laurapellizari/PBLE01---Hardware/README.md

# PBLE01---Hardware
Embedded hardware design for learning

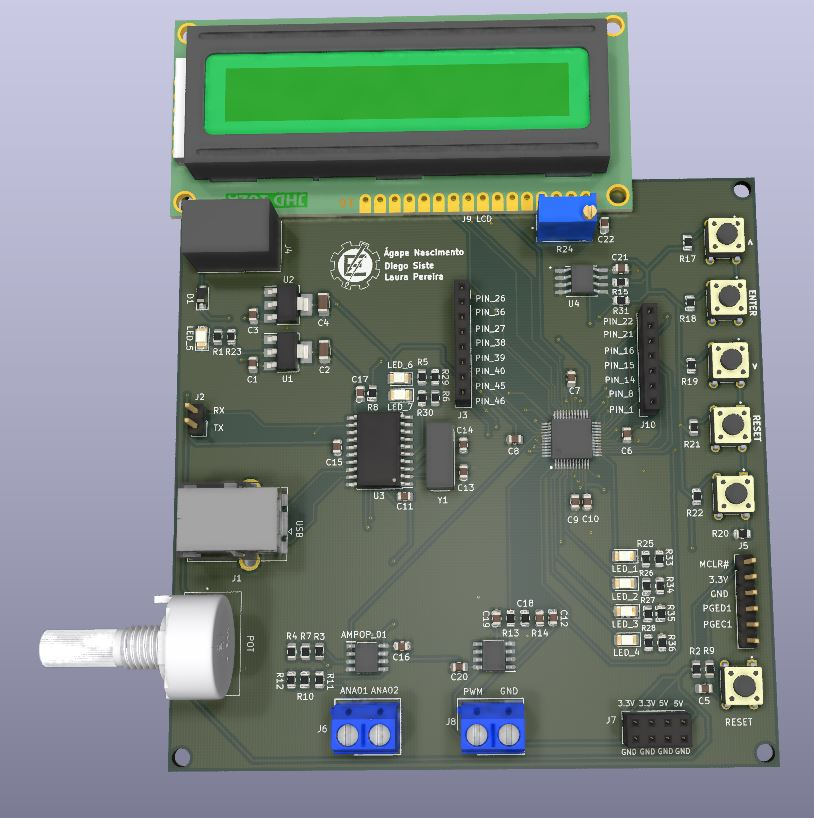
[picture p1: VH3/3D/LCD_visao1.JPG]
