laurapellizari/PBLE01---Hardware/VH3/VH3_RELATORIO.pdf

UNIVERSIDADE FEDERAL DE ITAJUBÁ

APRENDIZAGEM BASEADA EM PROJETOS I

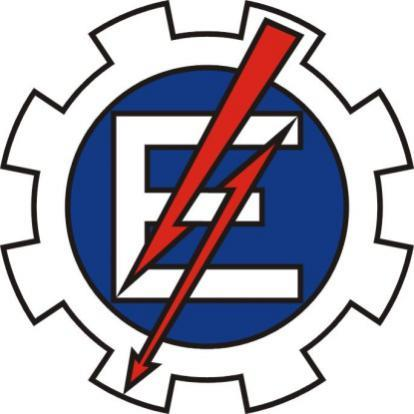
[picture p3: figure]

## Documentação Final

Ágape Guilherme Nascimento da Fonseca – 2018012168

Diego Siste Barbosa – 2019000279

Laura Pellizari Pereira – 2019018756

ITAJUBÁ-MG

2020

Introdução

Este documento possui como objetivo a apresentação de forma detalhada e exemplificada

dos procedimentos e escolhas tomados no desenvolvimento da placa de circuito impresso para

a disciplina Aprendizagem Baseada em Projetos I (PBLE01), do curso de Engenharia Eletrônica

da Universidade Federal de Itajubá (Unifei).

Encontram-se presentes neste registro os requisitos de projeto, esquemas elétricos, layouts,

memoriais de cálculo, anotações referentes a falhas e sucessos, diagramas UML e da máquina

de estado.

Os datasheets citados neste documento encontram-se anexados em uma pasta denominada

“DATASHEETS”.

Sumário

### 1 Hardware

### 1.1. Blocos Funcionais Exigidos

Figura 1 – Blocos Funcionais Exigidos

### 1.2. Subcircuito do Microcontrolador

Especificações:

- Empregar o microcontrolador PIC32MM0064GPM048-I/PT;
- Operar com clock interno;
- Possuir quatro diodos emissores de luz para sinalizações diversas;
- Possuir um botão de reinício do microcontrolador por meio de uma chave táctil de

quatro terminais e do tipo normalmente aberta;

- Possuir uma barra de pinos de programação para o padrão ICSP de 6 pinos (para

gravar o microcontrolador).

Os diodos emissores de luz foram conectados nas entradas digitais 2, 3, 5 e 13 do

microcontrolador.

Utilizando a datasheet “MICRO”, página 24, obteve-se o seguinte circuito para o botão de

reinício e uma barra de pinos no padrão ICSP. Optou-se por PGEC1 e PGED1.

µC

1

### aimentação

2

### comunicação

3

### periféricos

4

### interface

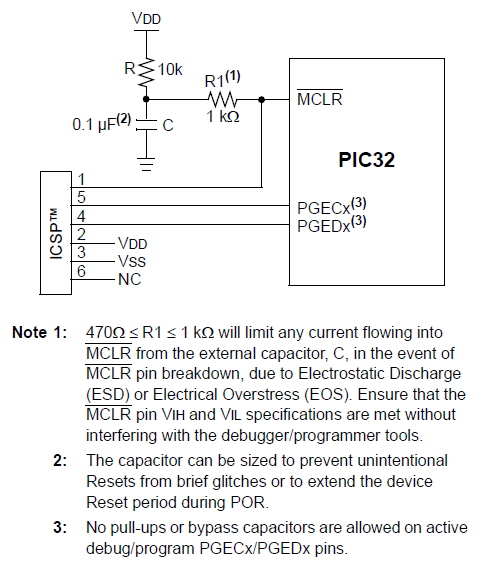
[picture p4: figure]

Figura 2 – Circuito referente ao MCLR

Para o cálculo da resistência do led, foi obtido no datasheet “LTST-C15GKT”, página 4, que

a tensão típica e a corrente típica são, respectivamente, 2.1 V e 20mA.

Dessa maneira,

R =

5− 2.1
0,02

= 145 Ω

Adotando valor comercial, foi utilizado uma associação em série de 100Ω e 56 Ω para as

resistências referentes aos leds.

Esquemático Elaborado:

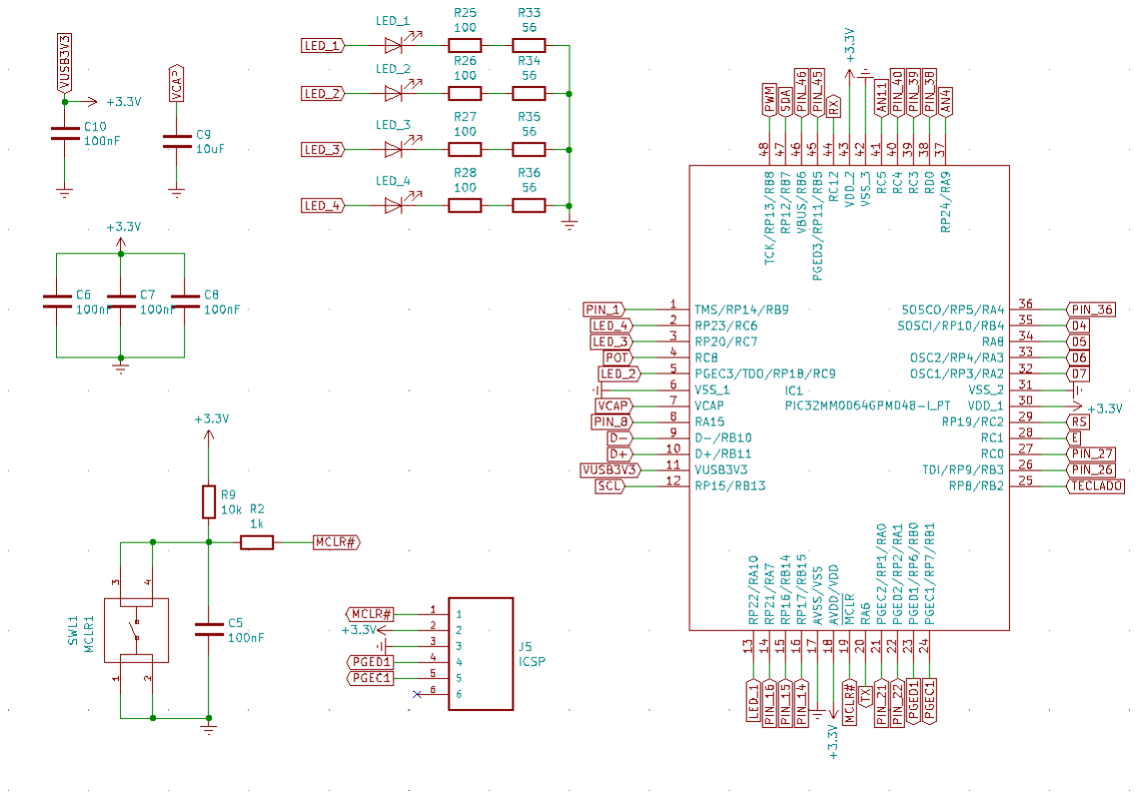
[picture p5: figure]

### 1.3. Subcircuito de Alimentação

Especificações:

- Empregar um conector do tipo jack J4 com diâmetro interno de 2.1mm e pino

central positivo;

•Suportar tensão de entrada na faixa de 7 a 12V em corrente contínua;

•Empregar proteção contra tensão reversa por meio de um diodo retificador

schottky;

•Empregar um regulador linear com saída de 5V;

•Empregar um regulador linear com saída de 3.3V;

•Possuir um diodo emissor de luz para sinalizar a presença de alimentação.

Figura 3 – Esquema Elaborado

Para a implementação do regulador de tensão, baseou – se no circuito encontrado na página

8 do datasheet “LD117” correspondente à imagem abaixo.

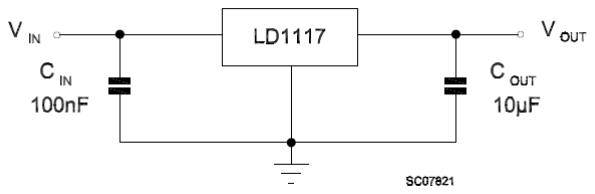
[picture p6: figure]

Para o cálculo da resistência do led foi utilizado o mesmo raciocínio dos leds do

microcontrolador.

Esquemático Elaborado:

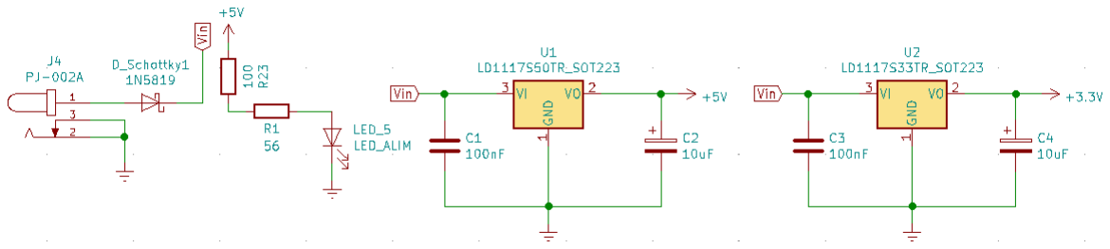
[picture p7: figure]

Figura 5 - Subcircuito de Alimentação

### 1.4. Subcircuito de Comunicação

Especificação:

•Empregar um conversor USB-serial da devidamente integrado ao periférico de

comunicação UART do microcontrolador. Utilizar a configuração autoalimentada para

energizar o conversor;

•Preparar a placa para montar o MCP2200-I/SO

•Fornecer os pinos de TX e RX na borda da placa.

Alimentação:

Como informado no datasheet “MICRO”, página 182, o pino 11 do microcontrolador

(VUSB3V3) é usado para alimentar o transceptor USB, e os pinos 9 e 10 correspondem a,

respectivamente, D- e D+.

Figura 4 - Circuito base para os reguladores de tensão

No mesmo datasheet, na página 318, é informado que a tensão de VUSB3V3 varia de 3.0

V a 3.6 V. Para o projeto foi escolhida uma tensão de 3.3 V.

Já no datasheet “MCP2200”, página 6, é dito que o transceptor USB obtém energia do pino

VUSB, e ainda, na página 1, que a tensão de operação está na faixa de 3.0 a 5.5V. Dessa

maneira, VUSB (pino 17) foi ligado a uma tensão de 3.3V e VDD (pino 1) a uma tensão de 5V.

Seguindo recomendações feitas neste mesmo datasheet, foram utilizados capacitores de

desacoplamento.

Aplicações:

Ainda baseado no mesmo datasheet, página 7, foi obtido o seguinte circuito referente ao

cristal, o qual foi conectado aos pinos 2 e 3.

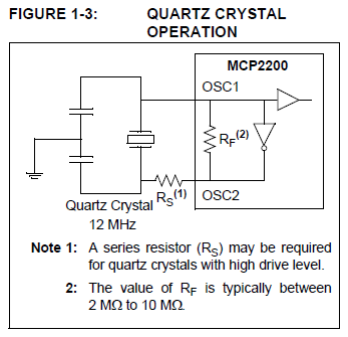
[picture p8: figure]

Figura 6 - Circuito do cristal

Os pinos 5 e 6 foram utilizados como leds de sinalização, cujas resistências foram calculadas

seguindo o mesmo padrão do subcircuito de alimentação e do microcontrolador.

Os pinos 12 e 10 (RX e TX, respectivamente) foram usados para comunicação UART,

conectados aos pinos 20 e 44 do microcontrolador.

O pino 4 foi conectado de maneira a se manter um nível alto constante.

Os demais pinos não foram utilizados.

Esquemático Elaborado:

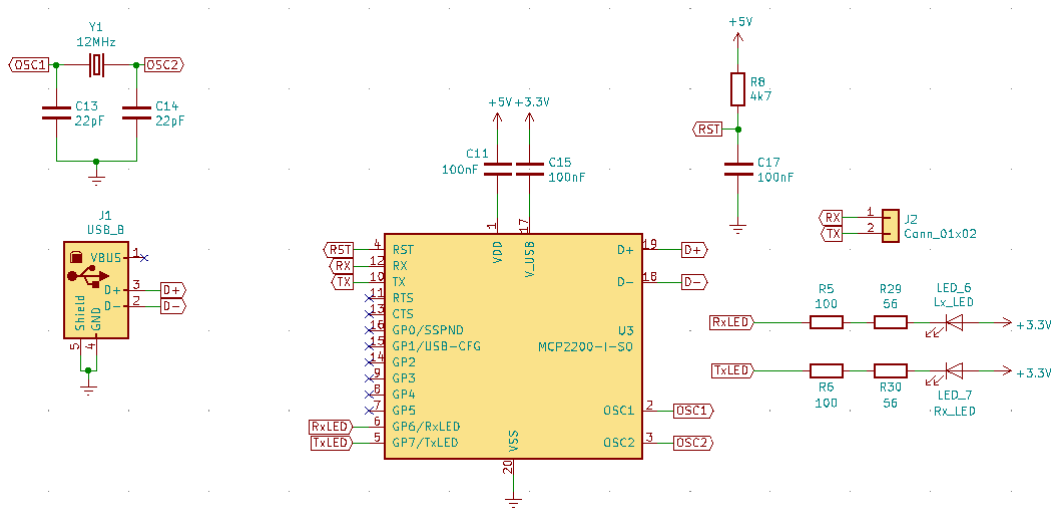
[picture p9: figure]

Figura 7 - Esquema Realizado

### 1.5. Subcircuito de Periféricos

Especificações:

- Possuir uma barra de conexão para um LCD de 16 x 2 pontos compatível com o

dispositivo JHD162A. Tal barra deve contemplar somente os pinos relacionados à

alimentação e à comunicação com o dispositivo por meio do modo de 4 bits. O pino relativo

à funcionalidade de luz de fundo do visor não deve ser energizado. Obs.: o JHD162A pode

ser alimentado com 5V e controlado com sinais de 3.3V (sinais RS, E, DB0-DB7);

- Possuir um teclado de cinco (5) teclas, desenvolvido por meio de chaves tácteis de

quatro (4) terminais cada, sendo lido através de uma estrutura de divisor resistivo numa

entrada analógica;

- Possuir uma memória serial com comunicação no padrão I2C.

A partir do datasheet “JHD162A_ETC”, página 17, foram obtidas as informações sobre a

compatibilidade para uma conexão LCD.

Para o teclado, os cálculos estão anexados na seção “Memorial de cálculo”.

A memória serial teve seus pinos 1, 2, 3 (correspondentes a A0, A1 e A2) conectados ao

terra.

Os pinos 5 e 6, correspondentes a SDA e SCL, foram conectados a um resistor de pull-up

(comunicação padrão I2C) e ao microcontrolador nos pinos 12 e 47, respectivamente.

O pino 7, WP, foi conectado ao terra, configuração esta que mantém a memória em operação

de gravação.

Segundo o datasheet “EEPROM”, página 1, a faixa de tensão de operação da memória em

questão é de 2.5 V a 5.5 V. Assim, o pino 8 foi conectado a 3.3 V, juntamente com um capacitor

de desacoplamento.

O pino 4, VSS, foi ligado ao terra.

Esquemático Elaborado:

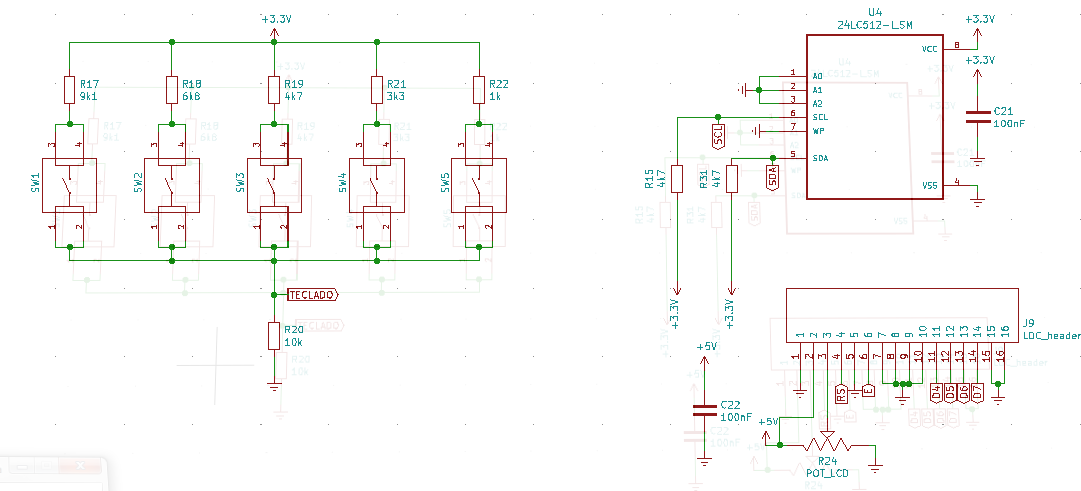
[picture p10: figure]

Figura 8 - Esquema Realizado

### 1.6. Subcircuito de Interface

Especificações:

- Possuir duas entradas analógicas de 0 a 3,3V com circuitos de buffer na entrada;

Possuir um potenciômetro ligado à uma entrada analógica do microcontrolador;

- Possuir uma saída analógica de 0 a 5V conectada a uma saída PWM do micro

utilizando um filtro passa baixa de 2ª ordem (40db/dec.) com 1 década a menos de FC que

a freq. do PWM.;

- Possuir uma barra de conexão para 4 pares de sinais de alimentação, dois como sinal

de 3.3V e dois de 5V, ambos com um terra associado, formato 2x4.

- Possuir um grupo de barras de expansão que empreguem todos os pinos do

microcontrolador que não sejam alocados pelos demais requisitos de desenvolvimento.

Cada barra deverá possuir um conjunto de pinos relativos a um dado periférico do microcontrolador (exemplo: uma barra para o periférico PWM, uma parra para o

periférico SPI, etc.).

Para obter uma faixa de tensão de 0 a 3.3 V foi projetado um divisor resistivo entre 3k3 Ω e

6k6 Ω, de maneira que ao implementar uma tensão de 5V, a tensão de saída será de 3.3V. As

entradas foram conectadas aos pinos 37 e 41 do microcontrolador.

Para os circuitos de buffer foi utilizado apenas um LM358DG, pois este possui dois

amplificadores operacionais.

Ligou-se o potenciômetro ao pino 4 do microcontrolador, correspondente à entrada

analógica.

Reservou-se o pino 48 (MCCP1 OUTPUT A) para o PWM.

Para o cálculo da frequência de corte do PWM, escolheu-se uma resolução de 10 bits
(2¹⁰ = 1024).

Multiplicando pela resolução máxima do microcontrolador , obtida em seu datasheet, na

página 1, temos:
21 ns x 1024 = 2.1504 x 10⁻⁵

Ao multiplicar pelo inverso, temos finalmente a frequência do microcontrolador: (2.1504 x 10⁻⁵
)

-1 = 46.6502 kHz

Como foi pedido uma década a menos, optou-se por utilizar uma frequência de corte de

5kHz.

O tipo de filtro passa baixa escolhido foi o Butterworth, e seus cálculos podem ser

encontrados na seção “Memorial de cálculo”.

Para a barra de conexão foi utilizado um pin header de 02x04 e para a barra de expansão foi

utilizado um de 01x07 e outro de 01x08.

Esquemático Elaborado:

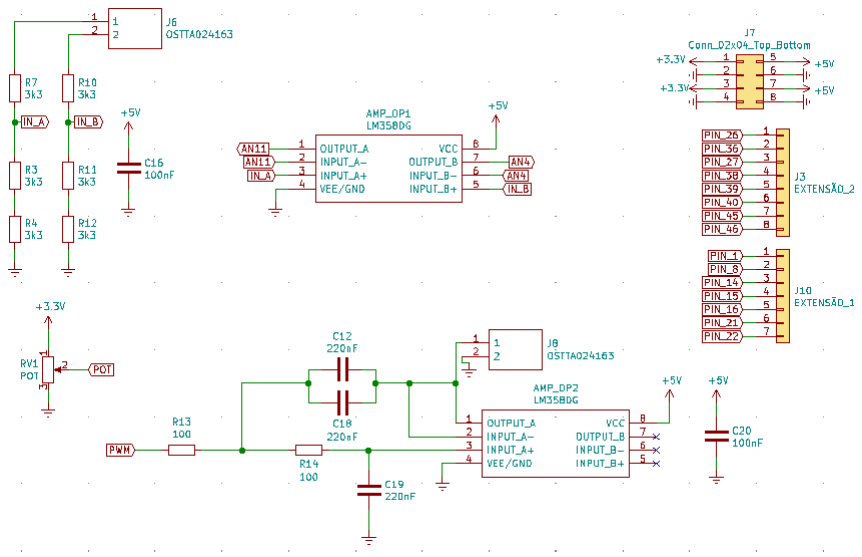
[picture p11: figure]

Figura 9 - Esquema Realizado

### 1.7. Memorial de cálculo e anotações referentes ao projeto:

i) Buffer

Sabendo que a queda de tensão no resistor R2 é de U2 = 3.3V e a queda no resistor R1 é

de U1 = 1.7V, assumimos o valor de 6k6Ω (uma associação em série de 3k3 Ω) para o resistor

R2.

Com o valor da resistência R2 e a tensão aplicada nele, conseguimos obter a corrente total

do circuito em série.

It =

U2
R2

=

3. 3
6600 = 0. 5mA

Com o valor de It e U1, conseguimos achar o valor da resistência R1.

R1 =

U1
It =
1. 7
0. 5 mA

≅ 3. 3kΩ

ii) Teclado analógico

A entrada analógica lê valores de 0 a 1024. Convertendo tensão nessa faixa de valores

temos:

0V – 0

3.3V – 1024

Pressionando SW1, temos:

V =

10k
9k1 + 10k

∗ 3. 3V = 1, 72 V

3.3V = 1024

1,72V = X

X= 533 (valor analógico)

Pressionando SW2, temos:

V =

10k
6k8 + 10k

∗ 3. 3V = 1, 96 V

3.3V = 1024

1,96 V = X

X=608 (valor analógico)

Pressionando SW3, temos:

V =

10k
4k7 + 10k

∗ 3. 3V = 2, 25V

3.3V = 1024

2,25 = X

X=696 (valor analógico)

Pressionando SW4, temos:

V =

10k
3k3 + 10k

∗ 3. 3V = 2, 48V

3.3V = 1024

2,48V = X

X=769 (valor analógico)

Pressionando SW5, temos:

V =

10k
1k + 10k

∗ 3. 3V = 3V

3.3V = 1024

3V = X

X=931 (valor analógico)

iii. Filtro passa-baixa

Para o dimensionamento do filtro, adotou-se como frequência ideal do PWM 5kHZ, e o

filtro Butterworth.

Sabendo que a fórmula da frequência de corte é:

Fc = 1
2√2πRC

Adotando R = 100 Ω, temos que C = 220nF.

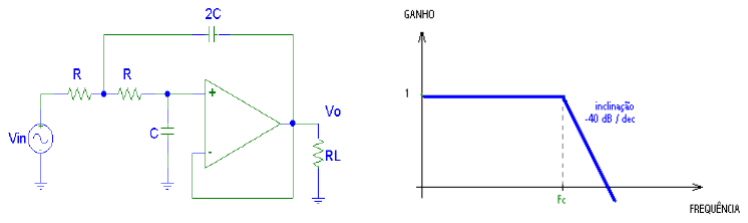
[picture p12: figure]

Figura 10 - Exemplo de filtro encontrado na apostila do prof Carlos Ayres

Para a simulação computacional do filtro foi utilizado o software LTSpice XVII, onde foi construído o seguinte circuito:

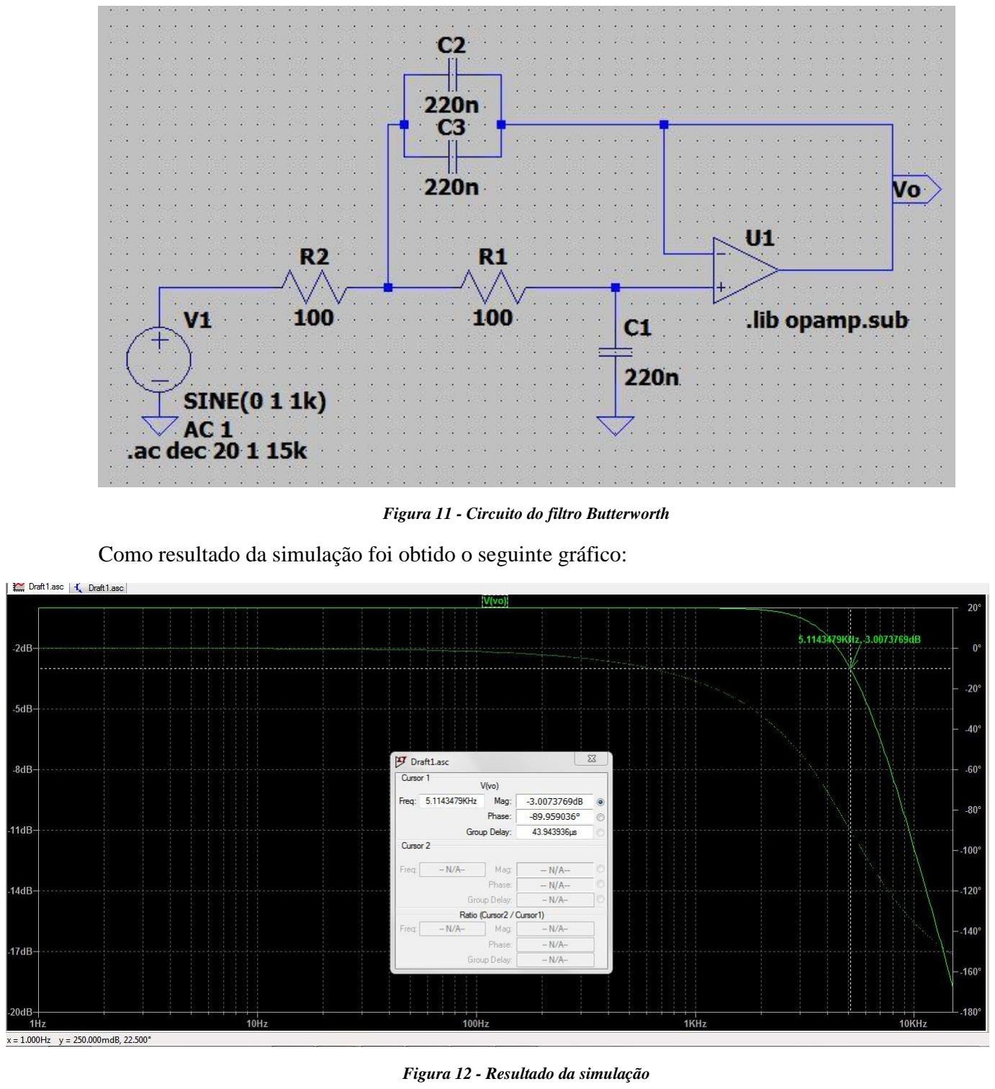
[picture p13: page 15]

Figura 11 - Circuito do filtro Butterworth

Como resultado da simulação foi obtido o seguinte gráfico:

Figura 12 - Resultado da simulação

### 1.8. Desenvolvimento do circuito impresso:

- Possuir dimensão de até 10x10 cm²;
- Ser de dupla face;
- Utilizar plano de terra em ambas as faces;
- Possuir capacitores de supressão de tensão entre a alimentação e o sinal de terra de

cada circuito integrado utilizado pelo projeto, alocados próximos aos pinos de

alimentação;

- Sua face superior deve possuir uma camada de texto (silk) na qual haja a

identificação de cada componente eletroeletrônico;

- Possuir a identificação do grupo e dos integrantes da equipe na camada de texto

(silk);

- Possuir quatro furos de fixação dispostos em seus cantos;
- Possuir identificação de todas as conexões de entrada e de saída presentes na placa.

Dimensão utilizada: 10x10cm.

### 1.9. Desenho virtual da placa e visão 3D:

Desenho virtual:

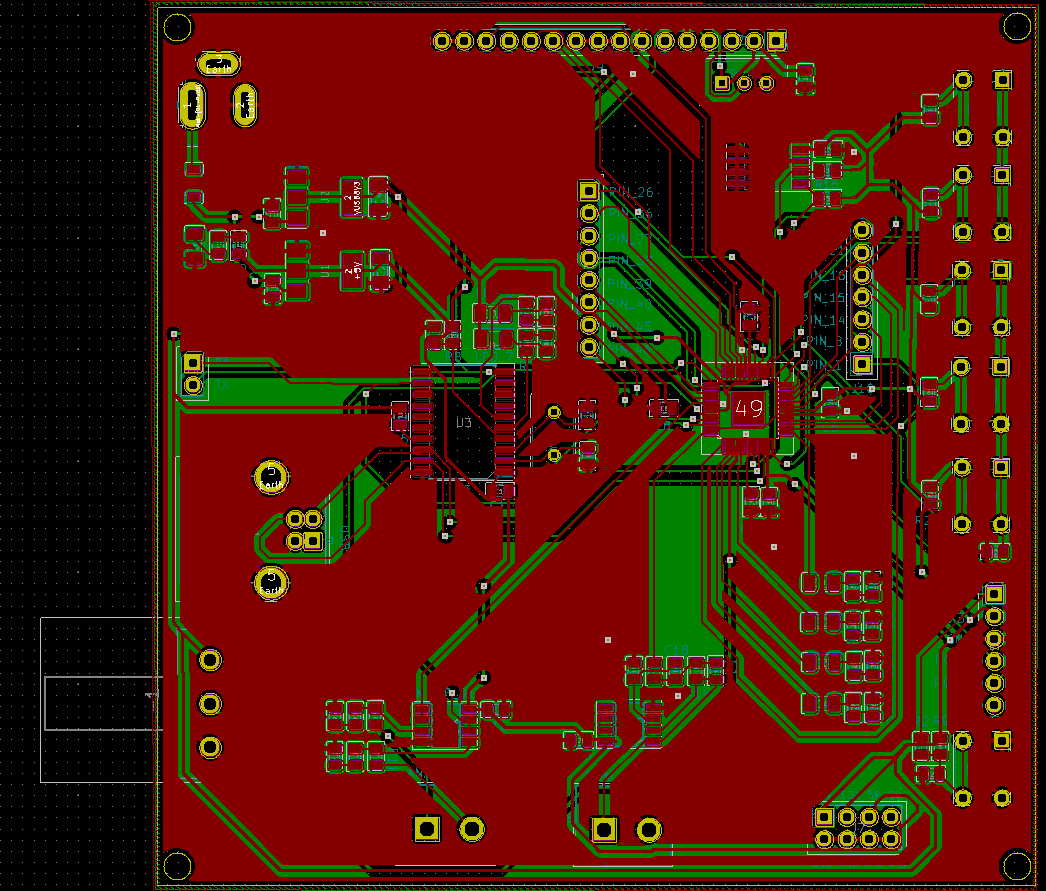
[picture p14: figure]

Figura 13 - Layout

Visão 3D:

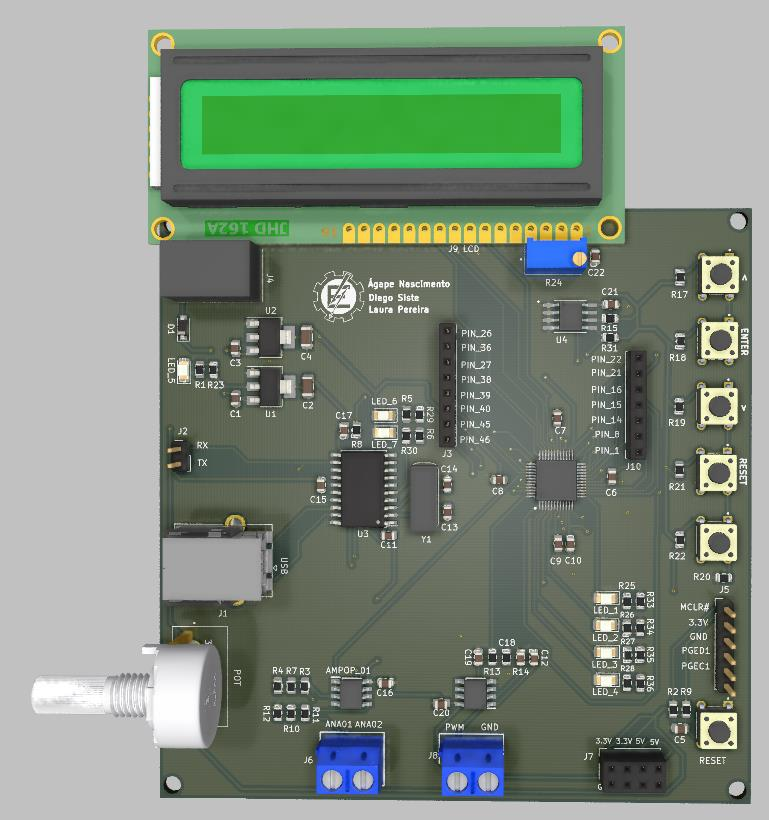
[picture p15: figure]

Figura 15 - Visão 3D

### 2 Software

### 2.1 Máquinas de Estado

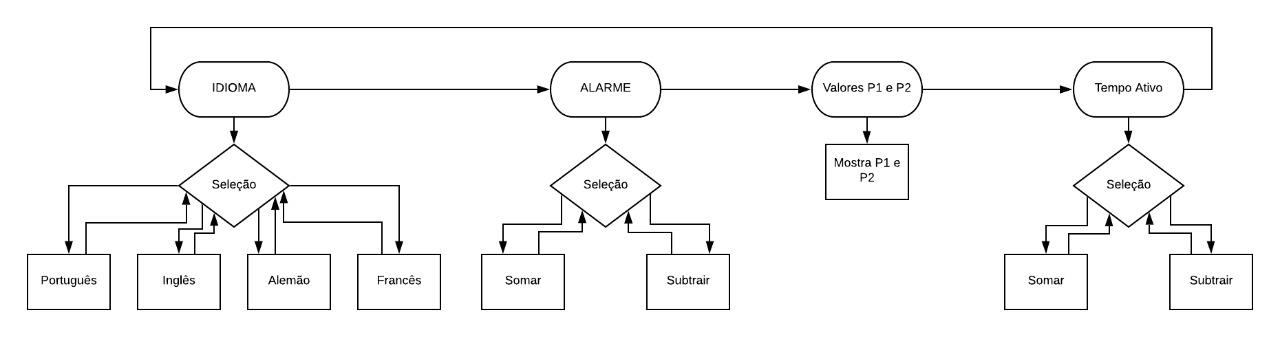
[picture p16: figure]

A máquina de estado em questão foi projetada com o objetivo de operar como um alarme.

Primeiro é feita a escolha de idioma, dentre 4 opções, seguida pela definição do horário do dia

e tempo e do tempo durante o qual ficará em atividade. Após as definições anteriores, são

selecionados os valores a serem sensoriados para o disparo do alarme, encerrando assim as

informações necessárias para funcionamento. Deste modo, a máquina de estado exibirá as horas

até algum disparo de evento iniciá-la novamente.

Figura 15 - Diagrama Máquina de estados

### 2.2 Diagrama UML

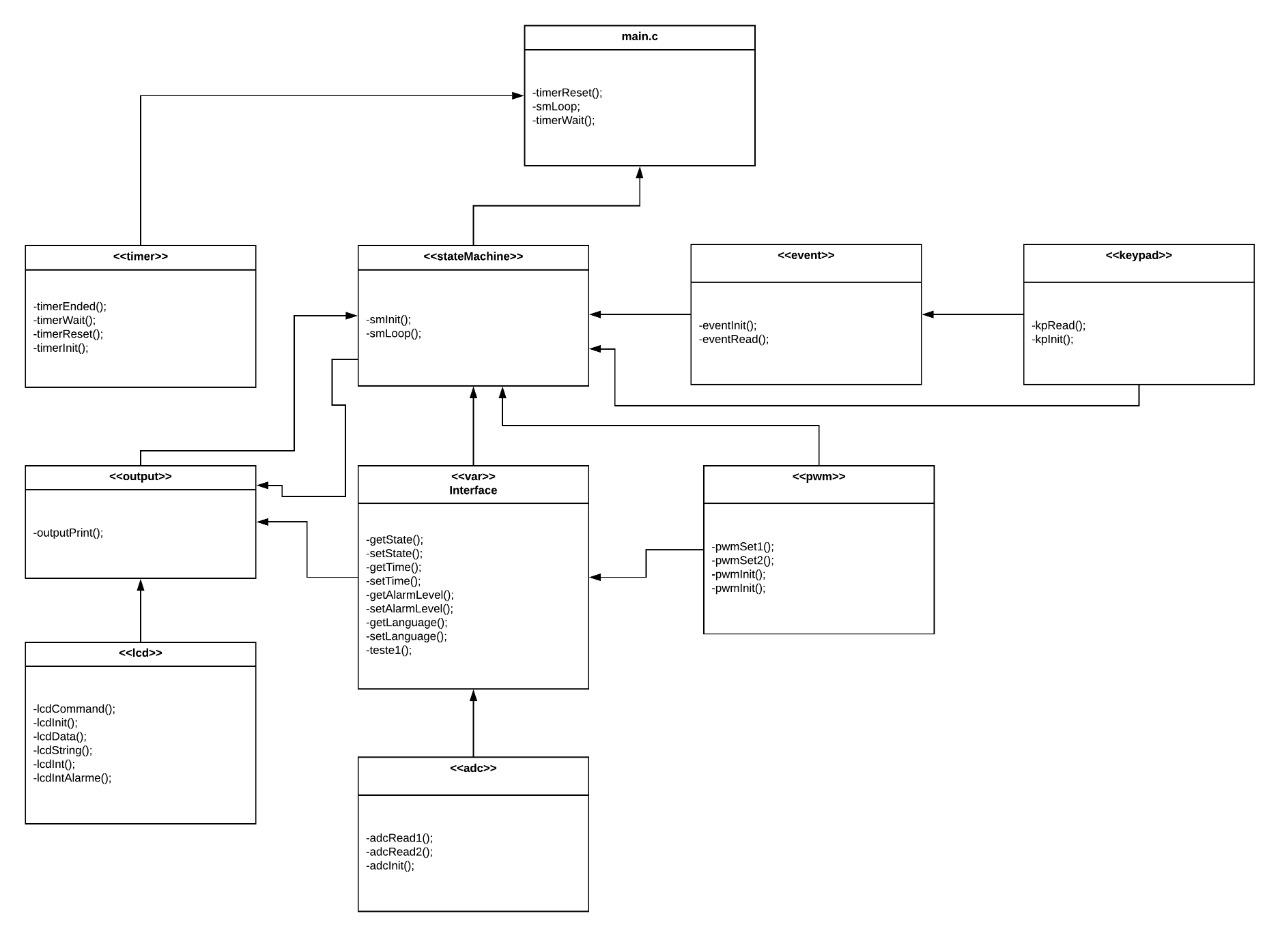
[picture p17: figure]

Figura 16 - Diagrama UML

### 3 Receita de compra de materiais

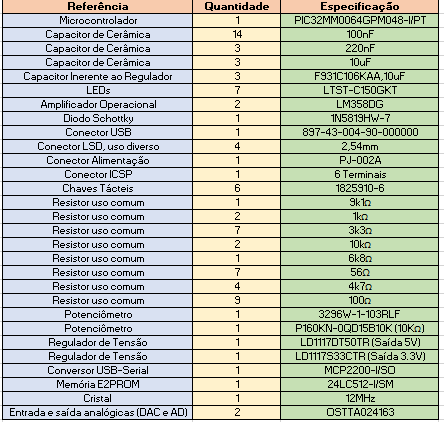
[picture p18: figure]

Figura 17 - Lista de Componentes

### 4 Cotação dos Componentes

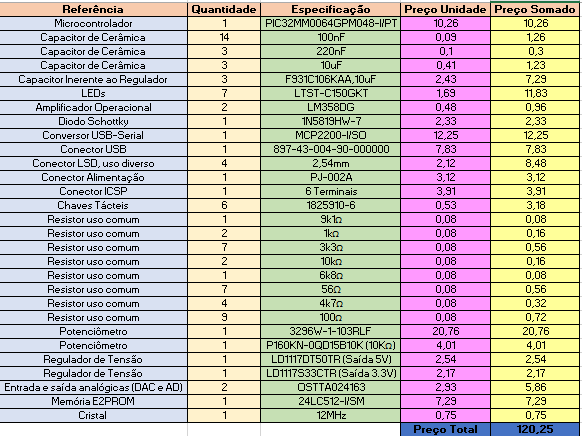
[picture p19: figure]

Figura 18 - Lista de compras

A cotação do projeto incluiu a cotação em dólar de diversos componentes. Assim sendo,

consideramos o valor estipulado de 5,28 Reais no dia da realização.

Tendo em vista o que foi exposto, o custo total do projeto é de R$ 120,25.

### 5 Conclusão

Com o desenvolvimento do trabalho, algumas dificuldades foram encontradas.

Nelas destaca-se o pouco conhecimento do software KiCad somado à falta de prática na

obtenção de informações de folhas de dados; isto levou o grupo a algumas divergências quanto

à representação esquemática do circuito.

Por exemplo, na representação do circuito em formato PCB foi necessária a utilização de

footprints, o que implica adicioná-las ao software. Todavia, diversos componentes não estavam

associados às footprints corretas, portanto foi preciso alterar algumas já existentes para que se

adequassem ao projeto. Situação parecida se deu com a visualização do modelo 3D.

Foi preciso empregar grande quantidade de vias no processo de roteamento da PCB, uma

vez que apenas utilizar as duas faces não foi suficiente para evitar o cruzamento de linhas.

Evidencia-se também a falta de datasheets com qualidade para certos componentes. Uma

vez que apresentam uma quantidade pequena de informações, acabam tornando trabalhoso seu

entendimento e utilização.

Assim sendo, registra-se que a maioria dos problemas acabaram sendo solucionados por

meio de pesquisas na Internet, baseando-se em projetos antigos e com o suporte fornecido pelo

professor da disciplina.

### 6 Anexos

i. Especificações elétricas da placa
- Tensão de Alimentação: 7 a 12V
- Tensão entradas analógicas: 0 a 5V
- Tensão Saída PWM: 0 a 5V
