laurapellizari/PBLE01---Hardware/sub_circ_alim/sub_circ_alim.jpg

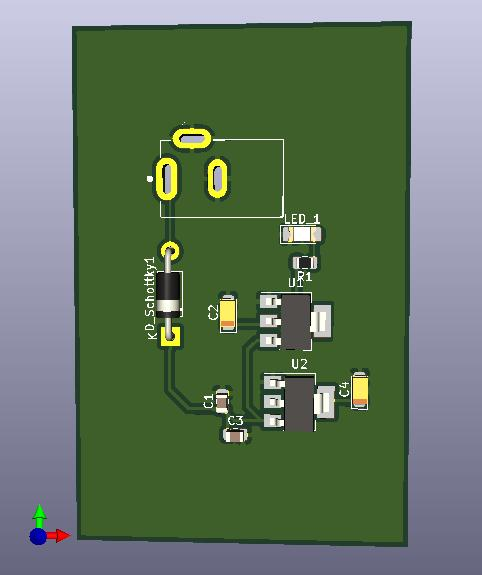
sub_circ_alim/sub_circ_alim.jpg
