laurapellizari/PBLE01---Hardware/sub_circ_completos/pcb_3D.jpg

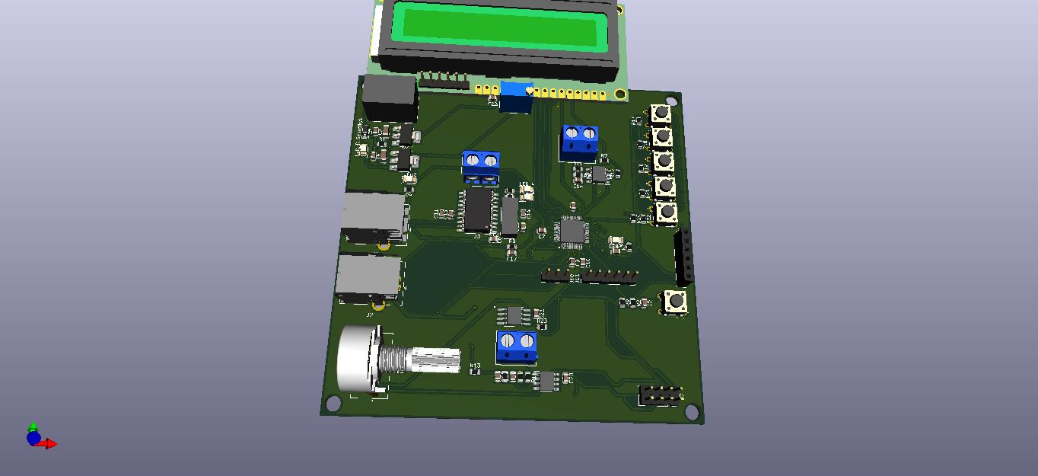
sub_circ_completos/pcb_3D.jpg
