laurapellizari/PBLE01---Hardware/sub_circ_completos/sem-nome2.jpg

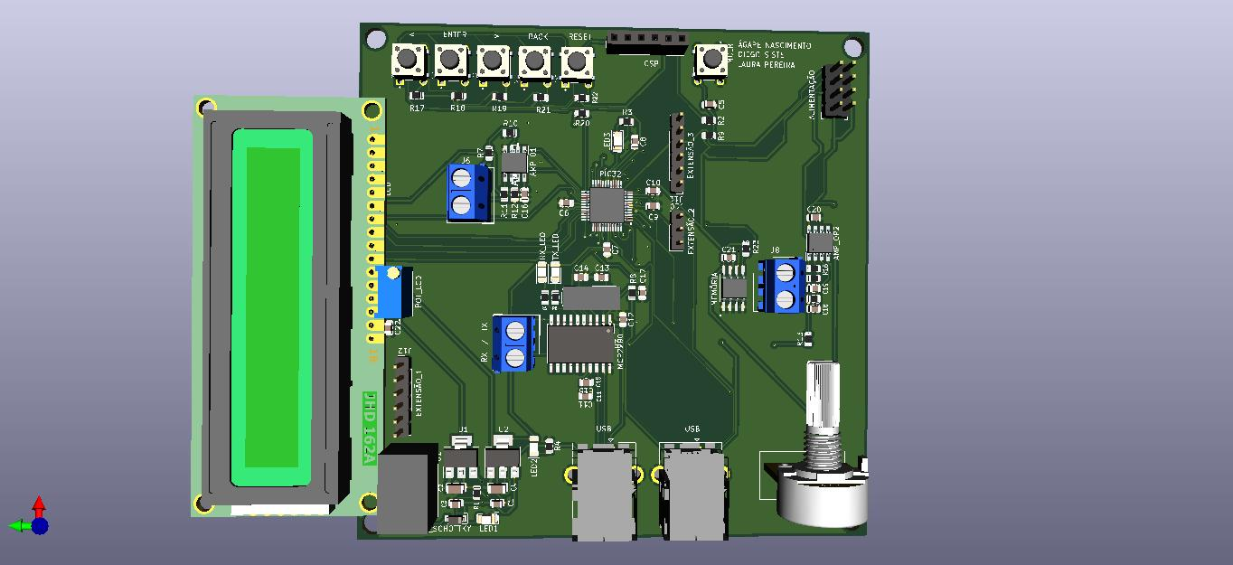
sub_circ_completos/sem-nome2.jpg
