laurapellizari/PBLE01---Hardware/sub_circ_completos/sem-nome.jpg

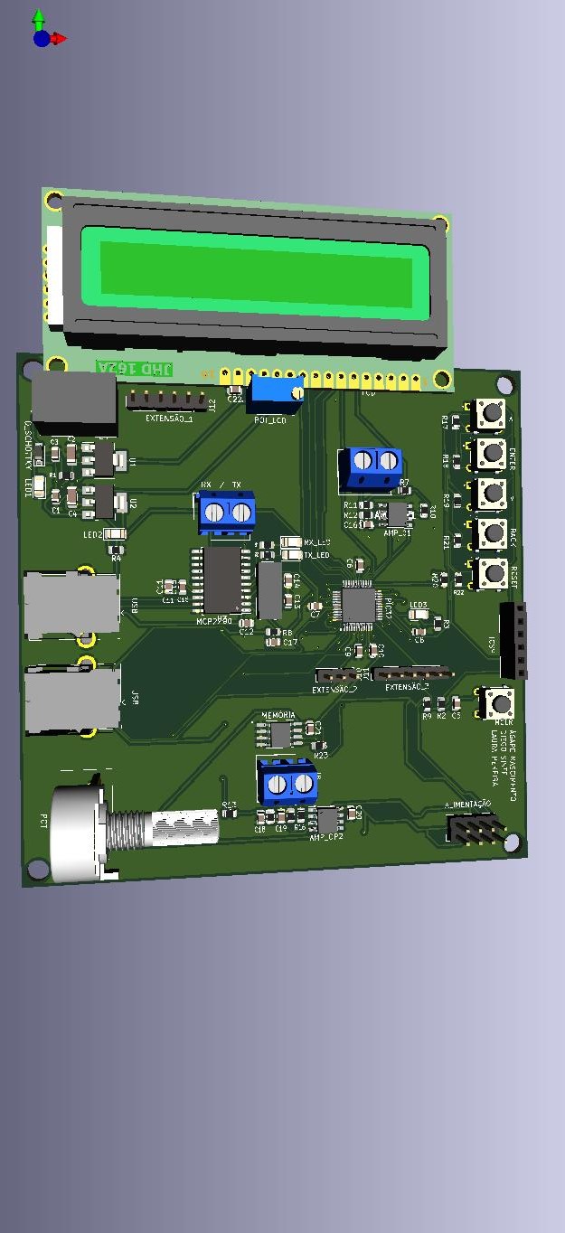
sub_circ_completos/sem-nome.jpg
