laurapellizari/PBLE01---Hardware/sub_circ_comunicacao/sub_circ_comunicacao.png

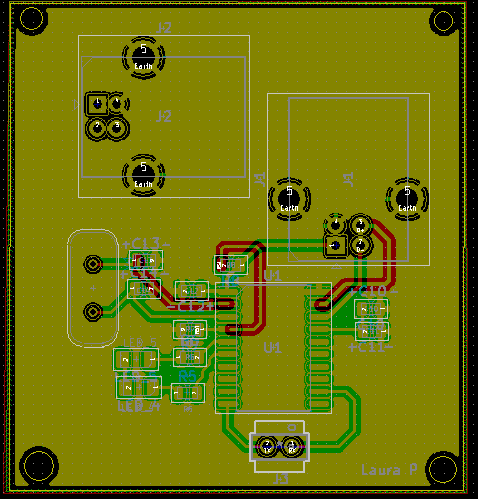
sub_circ_comunicacao/sub_circ_comunicacao.png
