laurapellizari/PBLE01---Hardware/sub_circ_interface/sub_circ_interface.png

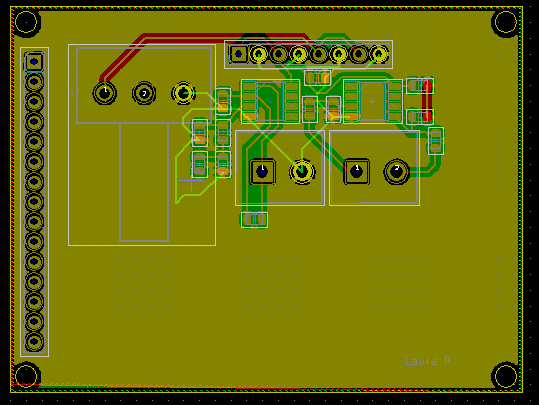
sub_circ_interface/sub_circ_interface.png
