laurapellizari/PBLE01---Hardware/sub_circ_perifericos/sub_circ_perifericos.png

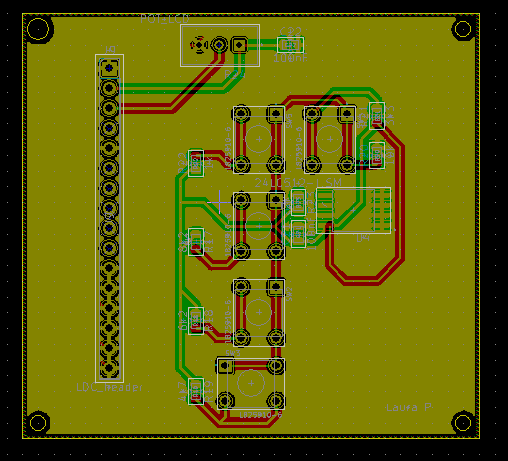
sub_circ_perifericos/sub_circ_perifericos.png
