laurapellizari/PBLE01---Hardware/documentacao/lista_de_compras.xlsx

Referência | Quantidade | Especificação | Preço Unidade | Preço Somado | Referência | Quantidade | Especificação
Microcontrolador | 1 | PIC32MM0064GPM048-I/PT | 10.26 | 10.26 | Microcontrolador | 1 | PIC32MM0064GPM048-I/PT
Capacitor de Cerâmica | 14 | 100nF | 0.09 | 1.26 | Capacitor de Cerâmica | 14 | 100nF
Capacitor de Cerâmica | 3 | 220nF | 0.1 | 0.3 | Capacitor de Cerâmica | 3 | 220nF
Capacitor de Cerâmica | 3 | 10uF | 0.41 | 1.23 | Capacitor de Cerâmica | 3 | 10uF
Capacitor Inerente ao Regulador | 3 | F931C106KAA,10uF | 2.43 | 7.29 | Capacitor Inerente ao Regulador | 3 | F931C106KAA,10uF
LEDs | 7 | LTST-C150GKT | 1.69 | 11.83 | LEDs | 7 | LTST-C150GKT
Amplificador Operacional | 2 | LM358DG | 0.48 | 0.96 | Amplificador Operacional | 2 | LM358DG
Diodo Schottky | 1 | 1N5819HW-7 | 2.33 | 2.33 | Diodo Schottky | 1 | 1N5819HW-7
Conversor USB-Serial | 1 | MCP2200-I/SO | 12.25 | 12.25 | Conector USB | 1 | 897-43-004-90-000000
Conector USB | 1 | 897-43-004-90-000000 | 7.83 | 7.83 | Conector LSD, uso diverso | 4 | 2,54mm
Conector LSD, uso diverso | 4 | 2,54mm | 2.12 | 8.48 | Conector Alimentação | 1 | PJ-002A
Conector Alimentação | 1 | PJ-002A | 3.12 | 3.12 | Conector ICSP | 1 | 6 Terminais
Conector ICSP | 1 | 6 Terminais | 3.91 | 3.91 | Chaves Tácteis | 6 | 1825910-6
Chaves Tácteis | 6 | 1825910-6 | 0.53 | 3.18 | Resistor uso comum | 1 | 9k1Ω
Resistor uso comum | 1 | 9k1Ω | 0.08 | 0.08 | Resistor uso comum | 2 | 1kΩ
Resistor uso comum | 2 | 1kΩ | 0.08 | 0.16 | Resistor uso comum | 7 | 3k3Ω
Resistor uso comum | 7 | 3k3Ω | 0.08 | 0.56 | Resistor uso comum | 2 | 10kΩ
Resistor uso comum | 2 | 10kΩ | 0.08 | 0.16 | Resistor uso comum | 1 | 6k8Ω
Resistor uso comum | 1 | 6k8Ω | 0.08 | 0.08 | Resistor uso comum | 7 | 56Ω
Resistor uso comum | 7 | 56Ω | 0.08 | 0.56 | Resistor uso comum | 4 | 4k7Ω
Resistor uso comum | 4 | 4k7Ω | 0.08 | 0.32 | Resistor uso comum | 9 | 100Ω
Resistor uso comum | 9 | 100Ω | 0.08 | 0.72 | Potenciômetro | 1 | 3296W-1-103RLF
Potenciômetro | 1 | 3296W-1-103RLF | 20.76 | 20.76 | Potenciômetro | 1 | P160KN-0QD15B10K (10KΩ)
Potenciômetro | 1 | P160KN-0QD15B10K (10KΩ) | 4.01 | 4.01 | Regulador de Tensão | 1 | LD1117DT50TR (Saída 5V)
Regulador de Tensão | 1 | LD1117DT50TR (Saída 5V) | 2.54 | 2.54 | Regulador de Tensão | 1 | LD1117S33CTR (Saída 3.3V)
Regulador de Tensão | 1 | LD1117S33CTR (Saída 3.3V) | 2.17 | 2.17 | Conversor USB-Serial | 1 | MCP2200-I/SO
Entrada e saída analógicas (DAC e AD) | 2 | OSTTA024163 | 2.93 | 5.86 | Memória E2PROM | 1 | 24LC512-I/SM
Memória E2PROM | 1 | 24LC512-I/SM | 7.29 | 7.29 | Cristal | 1 | 12MHz
Cristal | 1 | 12MHz | 0.75 | 0.75 | Entrada e saída analógicas (DAC e AD) | 2 | OSTTA024163
 |  |  | Preço Total | 120.25
