laurapellizari/PBLE01---Hardware/documentacao/componentes/3D/c-292304-1-b-3d.igs

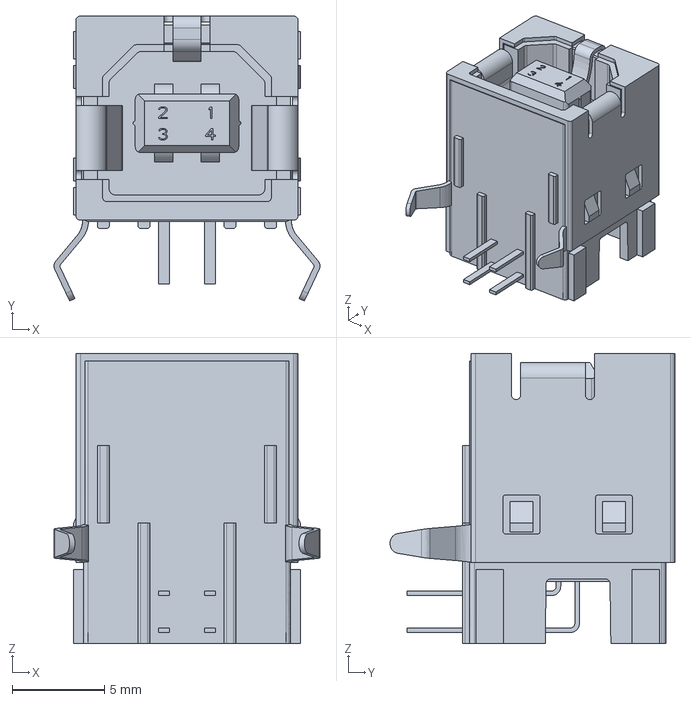
[picture p30: CAD file, 2022-01-19]
documentacao/componentes/3D/c-292304-1-b-3d.igs
14.4 x 15.4 x 15.7 mm
