laurapellizari/PBLE01---Hardware/VH3/COMPONENTES/3D/MCP2200-I_SO.stp

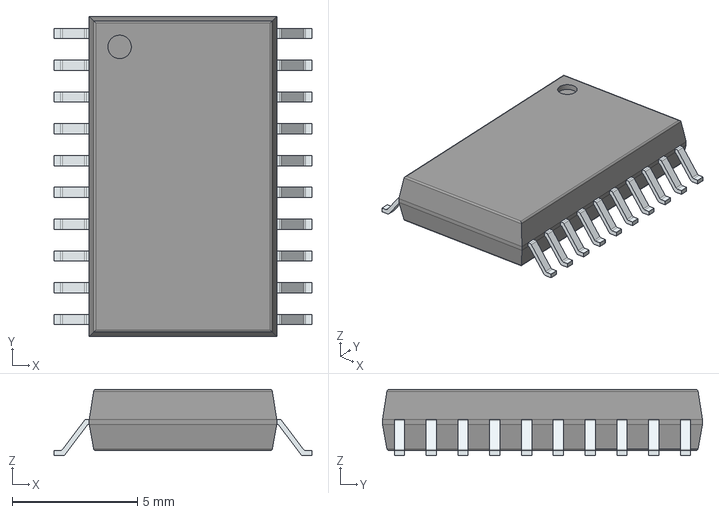
[picture p32: CAD file, 2022-01-19]
VH3/COMPONENTES/3D/MCP2200-I_SO.stp
10.3 x 12.8 x 2.65 mm
PinsArrayLR
