laurapellizari/PBLE01---Hardware/documentacao/componentes/3D/PIC32MM0256GPM048-I_PT.stp

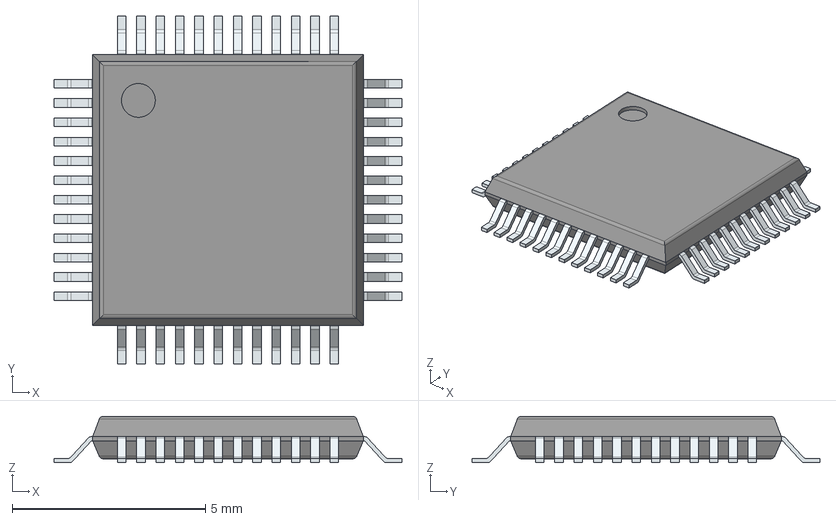
[picture p33: CAD file, 2022-01-19]
documentacao/componentes/3D/PIC32MM0256GPM048-I_PT.stp
9.00 x 9.00 x 1.20 mm
PinsArrayLR
PinsArrayTB
