laurapellizari/PBLE01---Hardware/VH3/COMPONENTES/3D/ATS12A.stp

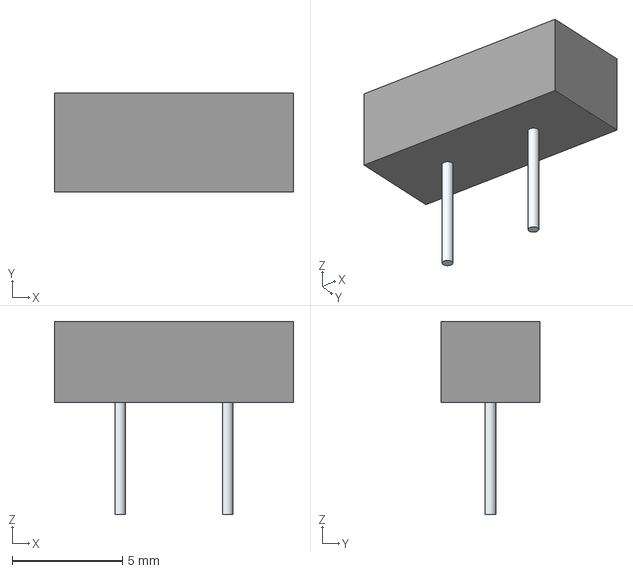
[picture p34: CAD file, 2022-01-19]
VH3/COMPONENTES/3D/ATS12A.stp
10.8 x 4.50 x 8.78 mm
Leads x 2
