laurapellizari/PBLE01---Hardware/VH3/COMPONENTES/3D/47K Potenziometer.step

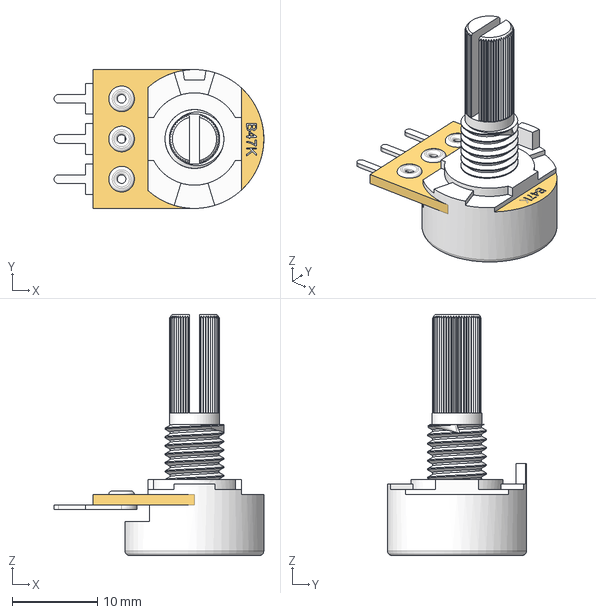
[picture p35: CAD file, 2022-01-19]
VH3/COMPONENTES/3D/47K Potenziometer.step
24.6 x 16.2 x 28.2 mm
