laurapellizari/PBLE01---Hardware/documentacao/componentes/3D/DPAK-L.step

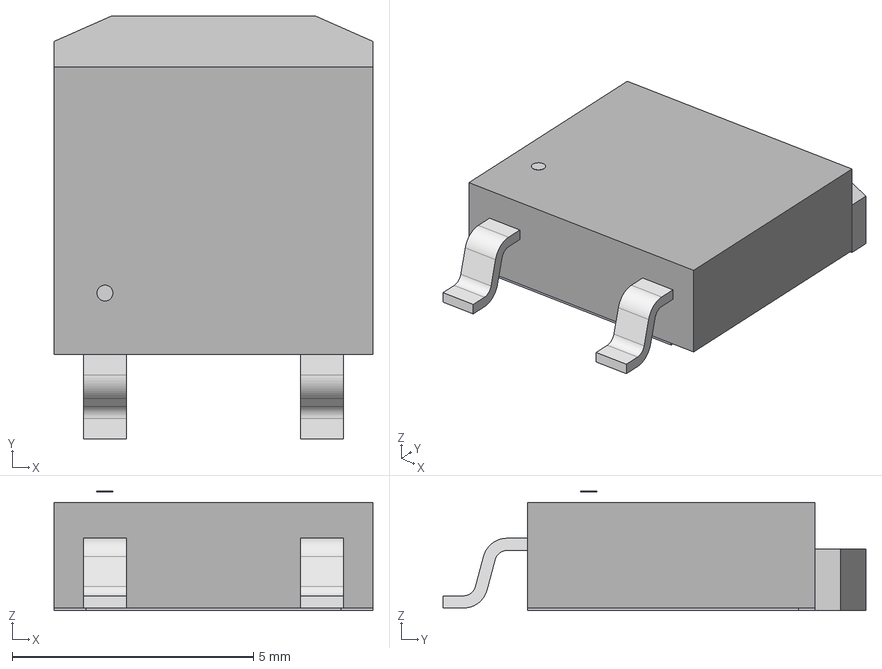
[picture p36: CAD file, 2022-01-19]
documentacao/componentes/3D/DPAK-L.step
6.60 x 8.77 x 2.47 mm
