laurapellizari/PBLE01---Hardware/documentacao/componentes/3D/tb5p-2p_p5_l10_w7-6_h10.stp

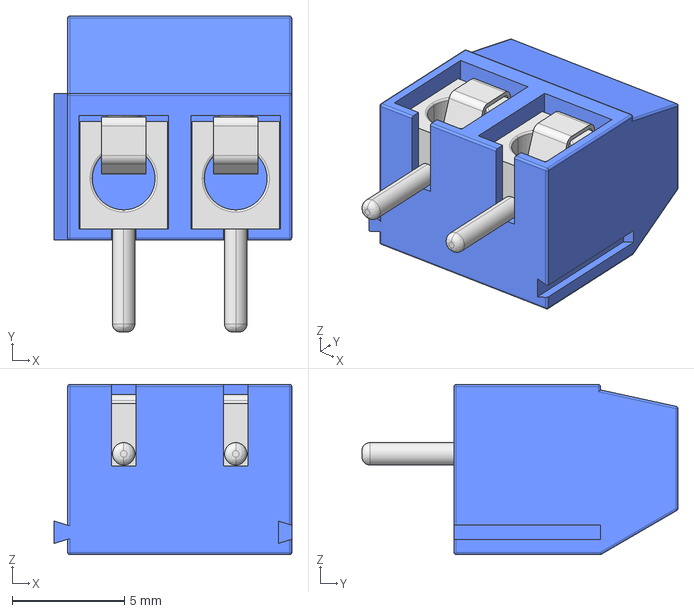
[picture p37: CAD file, 2022-01-19]
documentacao/componentes/3D/tb5p-2p_p5_l10_w7-6_h10.stp
10.6 x 14.1 x 7.60 mm
