laurapellizari/PBLE01---Hardware/documentacao/componentes/3D/LM358DG.stp

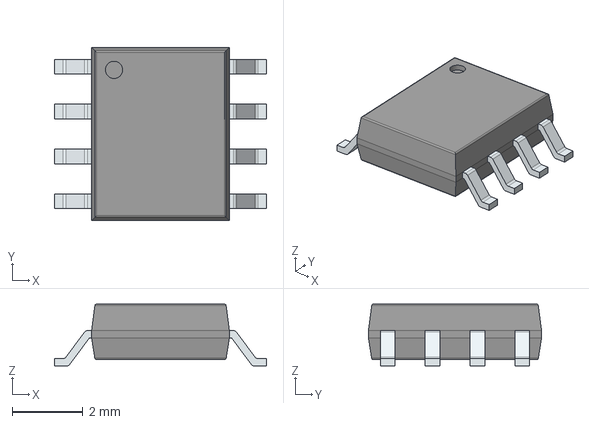
[picture p39: CAD file, 2022-01-19]
documentacao/componentes/3D/LM358DG.stp
6.00 x 4.90 x 1.75 mm
PinsArrayLR
