laurapellizari/PBLE01---Hardware/documentacao/componentes/3D/User Library-LCD 16x2 JHD162A.STEP

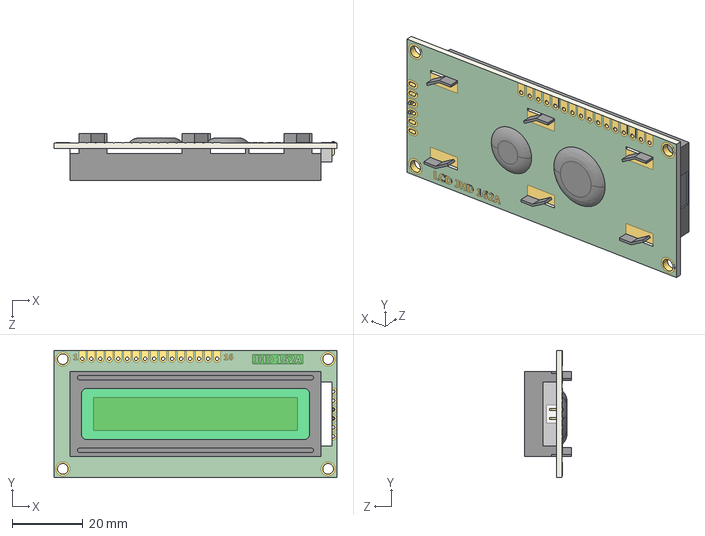
[picture p40: CAD file, 2022-01-19]
documentacao/componentes/3D/User Library-LCD 16x2 JHD162A.STEP
80.0 x 36.0 x 13.2 mm
