laurapellizari/PBLE01---Hardware/documentacao/componentes/3D/PJ-002AH.stp

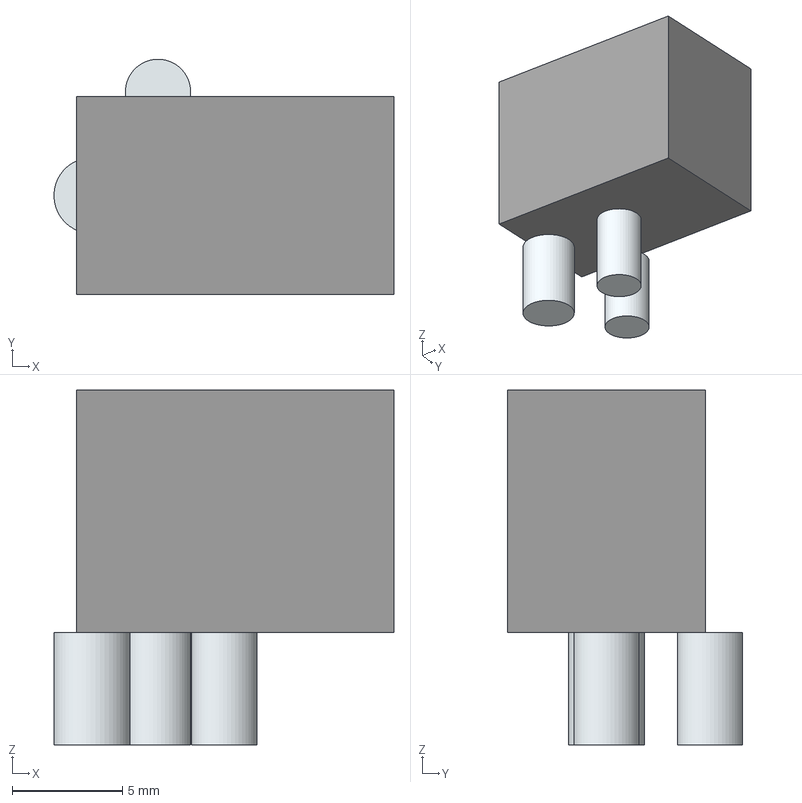
[picture p41: CAD file, 2022-01-19]
documentacao/componentes/3D/PJ-002AH.stp
15.4 x 10.7 x 16.1 mm
Leads x 3
