laurapellizari/PBLE01---Hardware/(list of files, cad)

Other CAD files:
VH3/COMPONENTES/3D/1825910-6--3DModel-STEP-56544.STEP
VH3/COMPONENTES/3D/PJ-002AH.stl
documentacao/componentes/3D/1825910-6--3DModel-STEP-56544.STEP
documentacao/componentes/3D/PJ-002AH.stl
