laurapellizari/PBLE01---Hardware/VH3/MANUAL.pdf

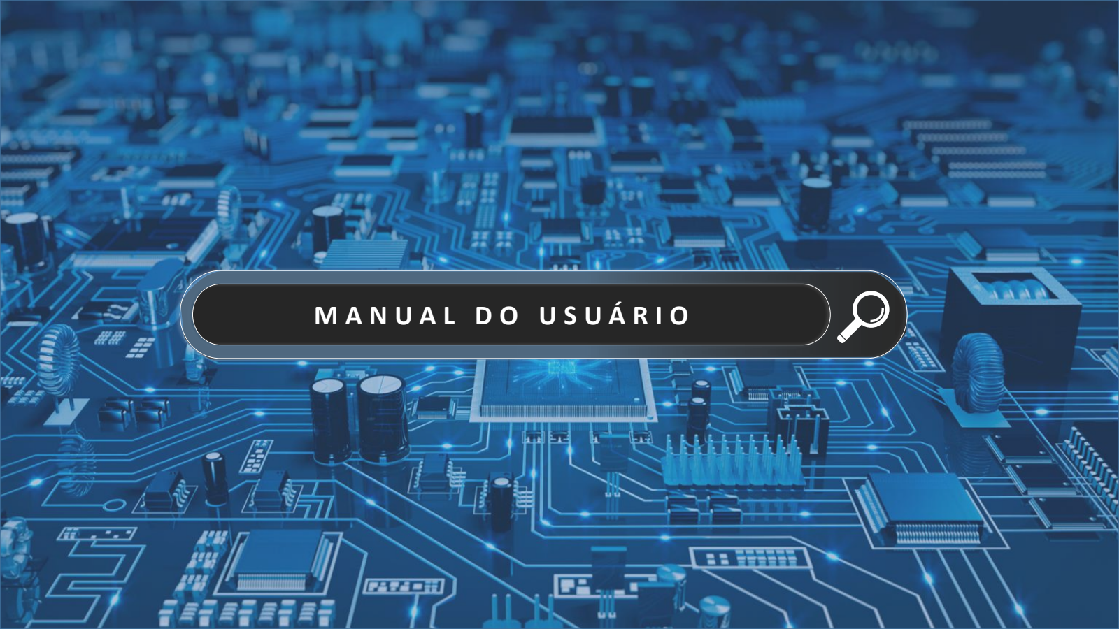
[picture p52: page 1]

# M A N U A L D O U S U Á R I O

# Sobre a placa

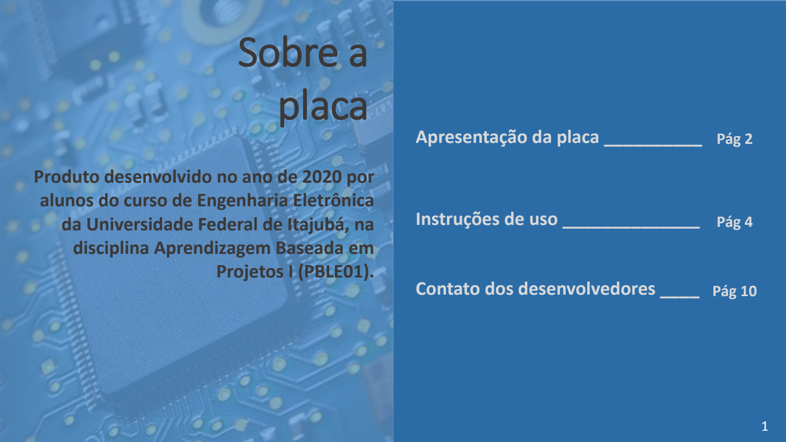
[picture p53: page 2]

# Produto desenvolvido no ano de 2020 por alunos do curso de Engenharia Eletrônica da Universidade Federal de Itajubá, na disciplina Aprendizagem Baseada em

Projetos I (PBLE01).

# Apresentação da placa __________ Pág 2

# Contato dos desenvolvedores ____ Pág 10

# Instruções de uso ______________ Pág 4

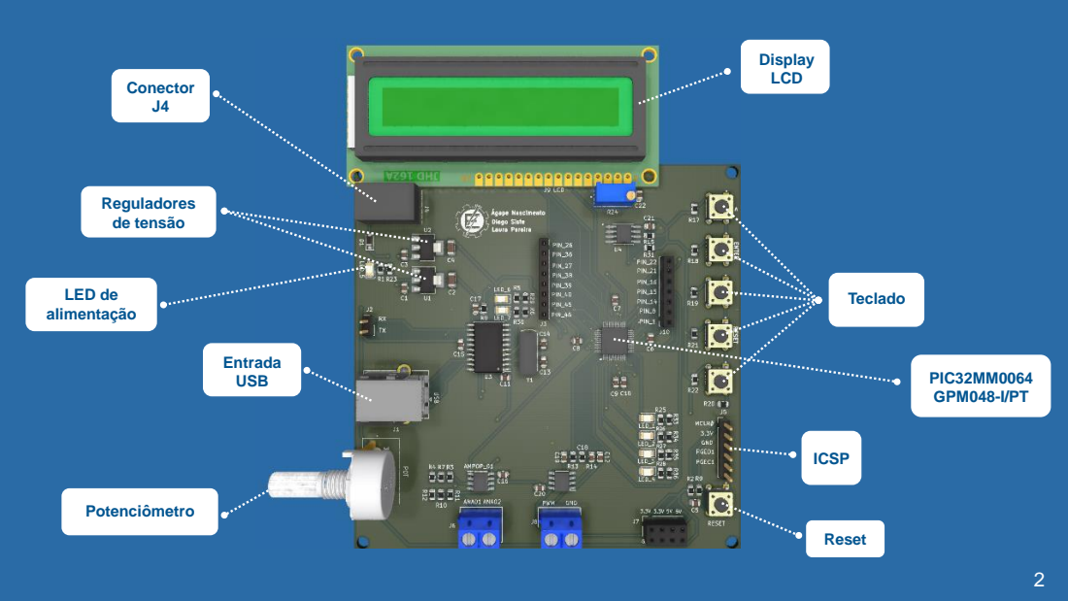
[picture p54: page 3]
Display LCD; Teclado; ICSP; Reset; Entrada USB; Potenciômetro; PIC32MM0064 GPM048-I/PT; LED de alimentação; Reguladores de tensão; Conector J4

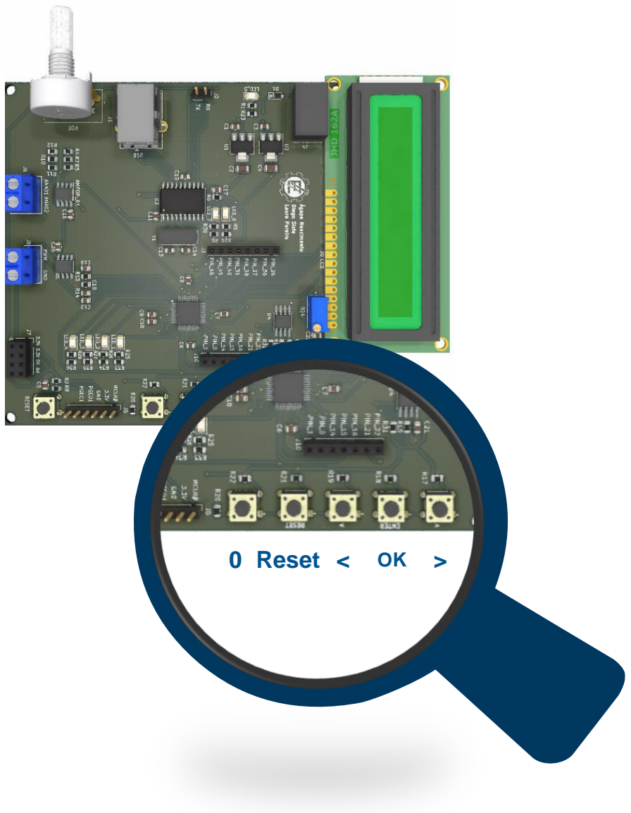
[picture p55: figure]
0 Reset <

>

OK

<

## Reset

0

Permite navegar para a esquerda.

Reseta a máquina de estados.

Botão não utilizado.

Permite mudar de função.

Permite navegar para a direita.

# Instruções de uso

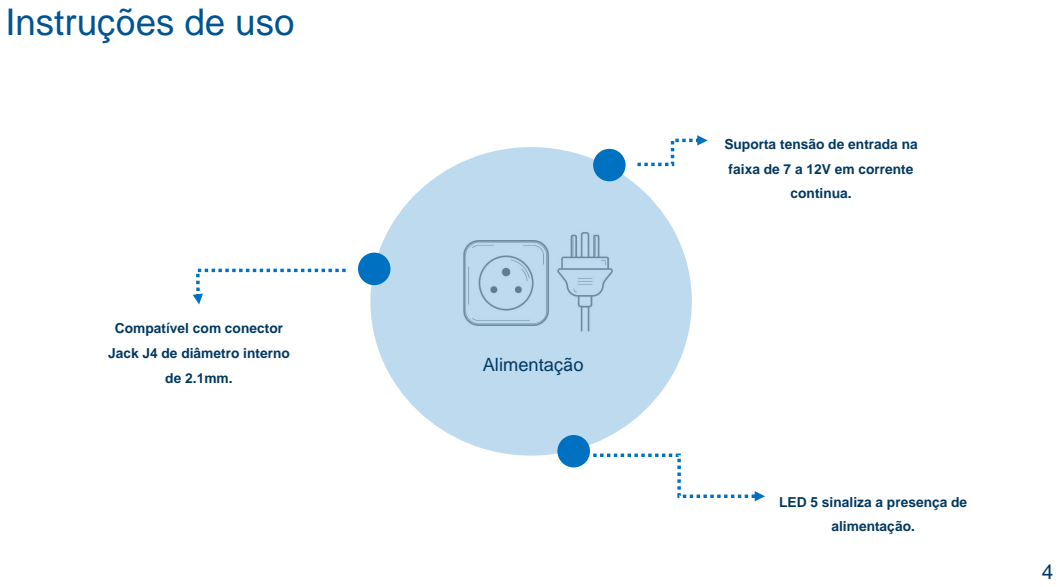
[picture p56: page 5]
continua.; Alimentação; alimentação.

Suporta tensão de entrada na
faixa de 7 a 12V em corrente

Compatível com conector
Jack J4 de diâmetro interno

LED 5 sinaliza a presença de

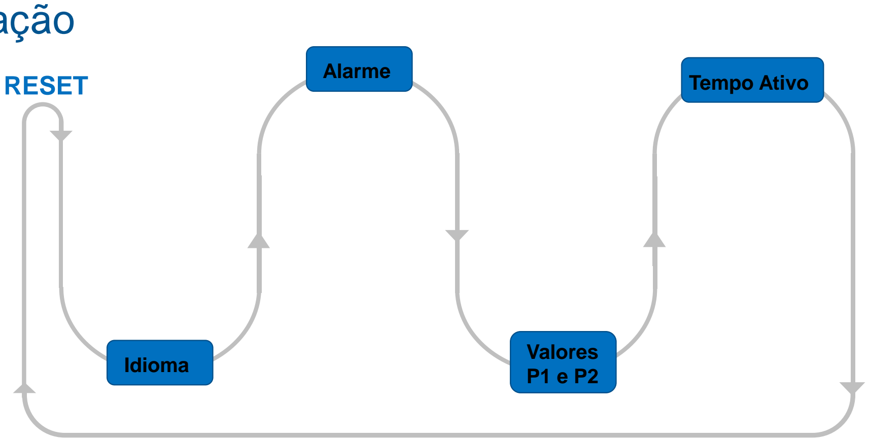
[picture p57: figure]
RESET; Idioma; Valores; Tempo Ativo Alarme

# Navegação

- A tela inicial que aparece para o usuário é a função de Idiomas.
- A partir dela é possível navegar pela função utilizando os botões “<“ e “>”.
- Pressione o botão “OK” para mudar de função.
- Para retornar à tela inical, basta pressionar o botão de reset.

# * Função Idioma:

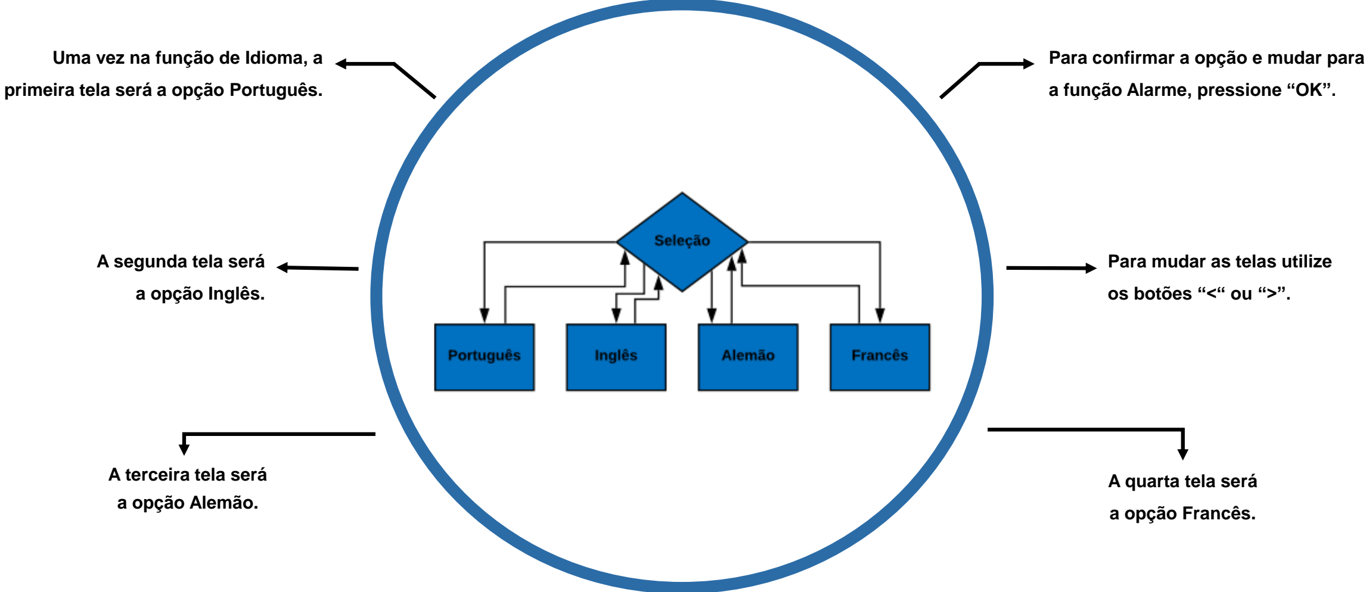
[picture p58: figure]
Uma vez na função de Idioma, a; primeira tela será a opção Português.; A segunda tela será; a opção Inglês.; A terceira tela será; a opção Alemão.; A quarta tela será; a opção Francês.; Para mudar as telas utilize; os botões “<“ ou “>”.; Para confirmar a opção e mudar para; a função Alarme, pressione “OK”.

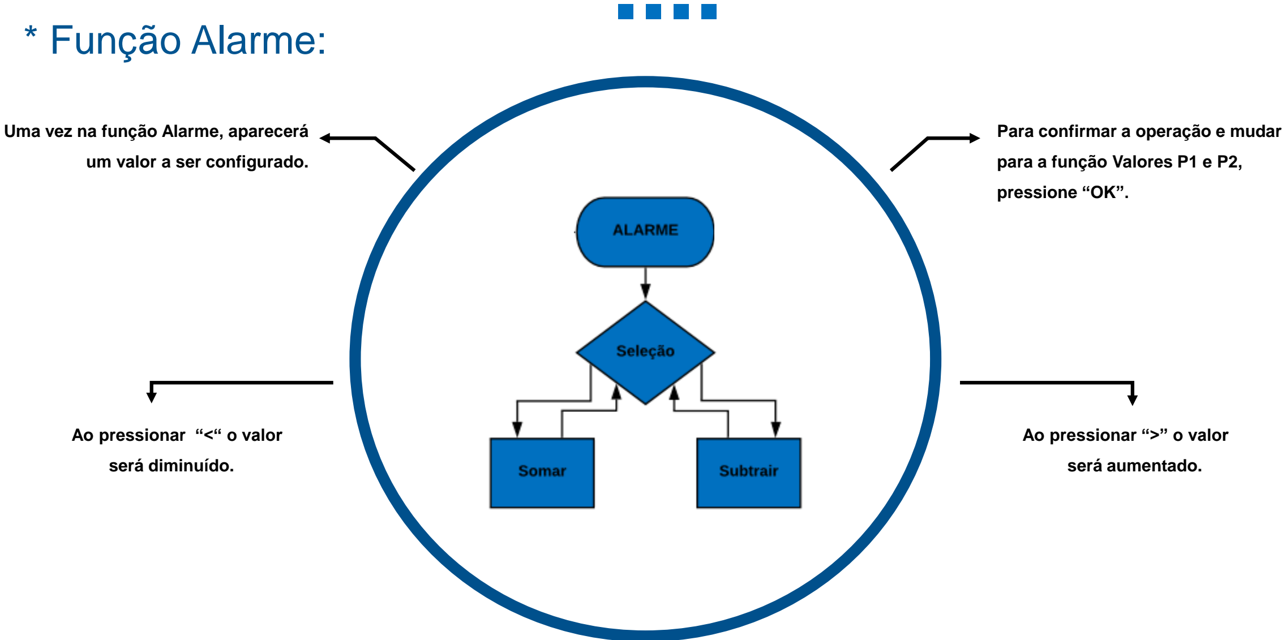
[picture p59: figure]
* Função Alarme:; Uma vez na função Alarme, aparecerá; um valor a ser configurado.; Ao pressionar “<“ o valor; será diminuído.; Para confirmar a operação e mudar; para a função Valores P1 e P2,; pressione “OK”.; Ao pressionar “>” o valor; será aumentado.

# * Função Valores P1 e P2:

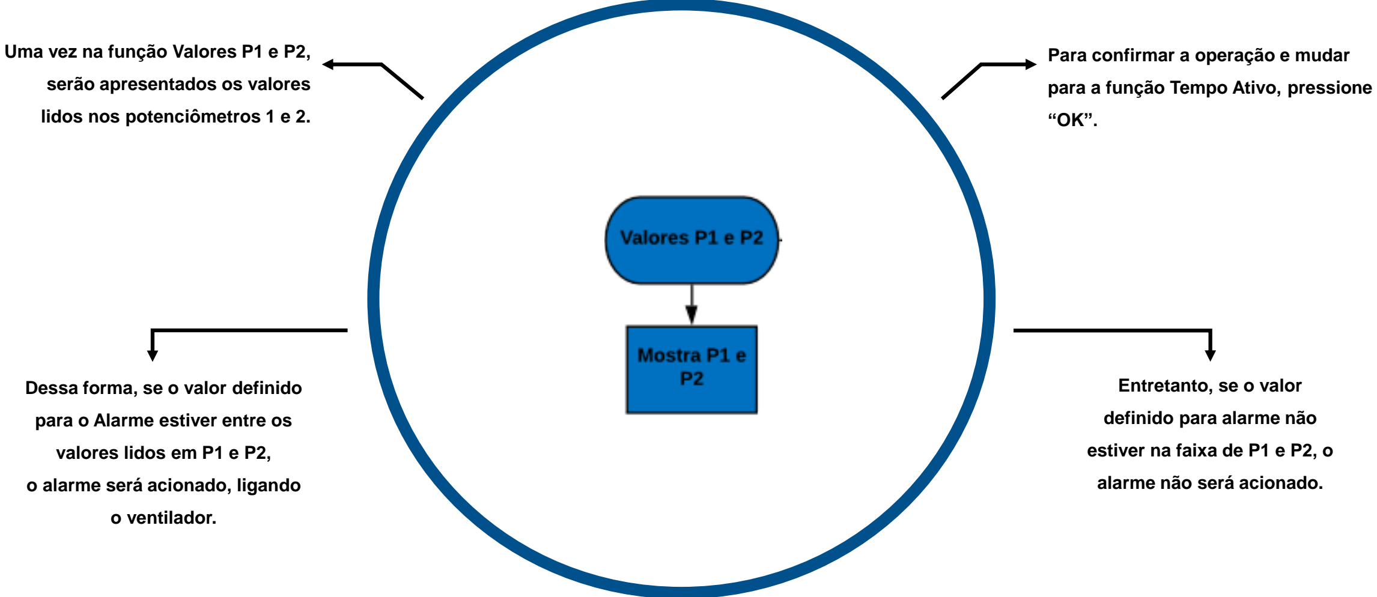
[picture p60: figure]
Uma vez na função Valores P1 e P2,; serão apresentados os valores; lidos nos potenciômetros 1 e 2.; Dessa forma, se o valor definido; para o Alarme estiver entre os; valores lidos em P1 e P2,; o alarme será acionado, ligando; o ventilador.; Entretanto, se o valor; definido para alarme não; estiver na faixa de P1 e P2, o; alarme não será acionado.; Para confirmar a operação e mudar; para a função Tempo Ativo, pressione

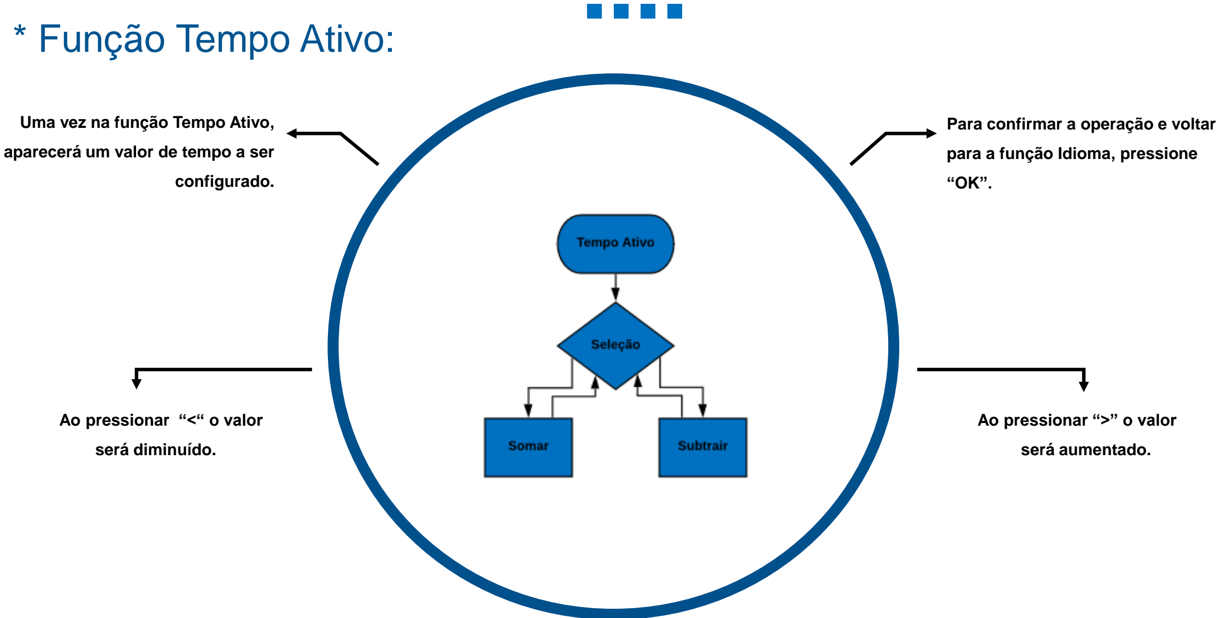
[picture p61: figure]
* Função Tempo Ativo:; Uma vez na função Tempo Ativo,; aparecerá um valor de tempo a ser; configurado.; Ao pressionar “<“ o valor; será diminuído.; Para confirmar a operação e voltar; para a função Idioma, pressione; Ao pressionar “>” o valor; será aumentado.
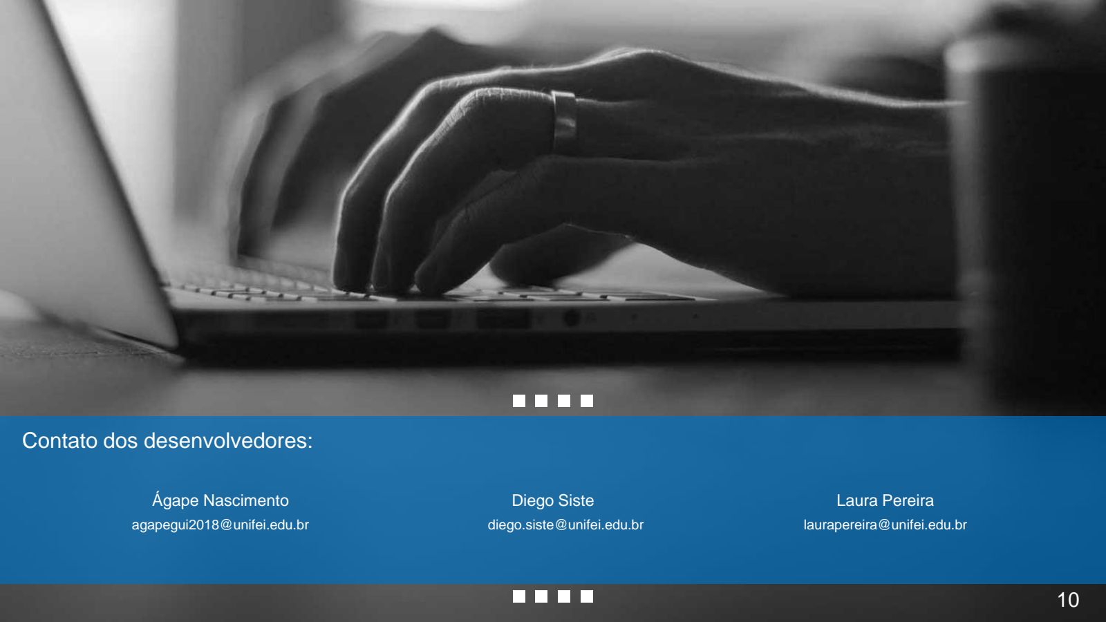
[picture p62: page 11]

## Contato dos desenvolvedores:

Ágape Nascimento | Diego Siste | Laura Pereira
agapegui2018@unifei.edu.br | diego.siste@unifei.edu.br | laurapereira@unifei.edu.br
