laurapellizari/PBLE01---Hardware/sub_circ_completos/sub_circ_completo.pdf

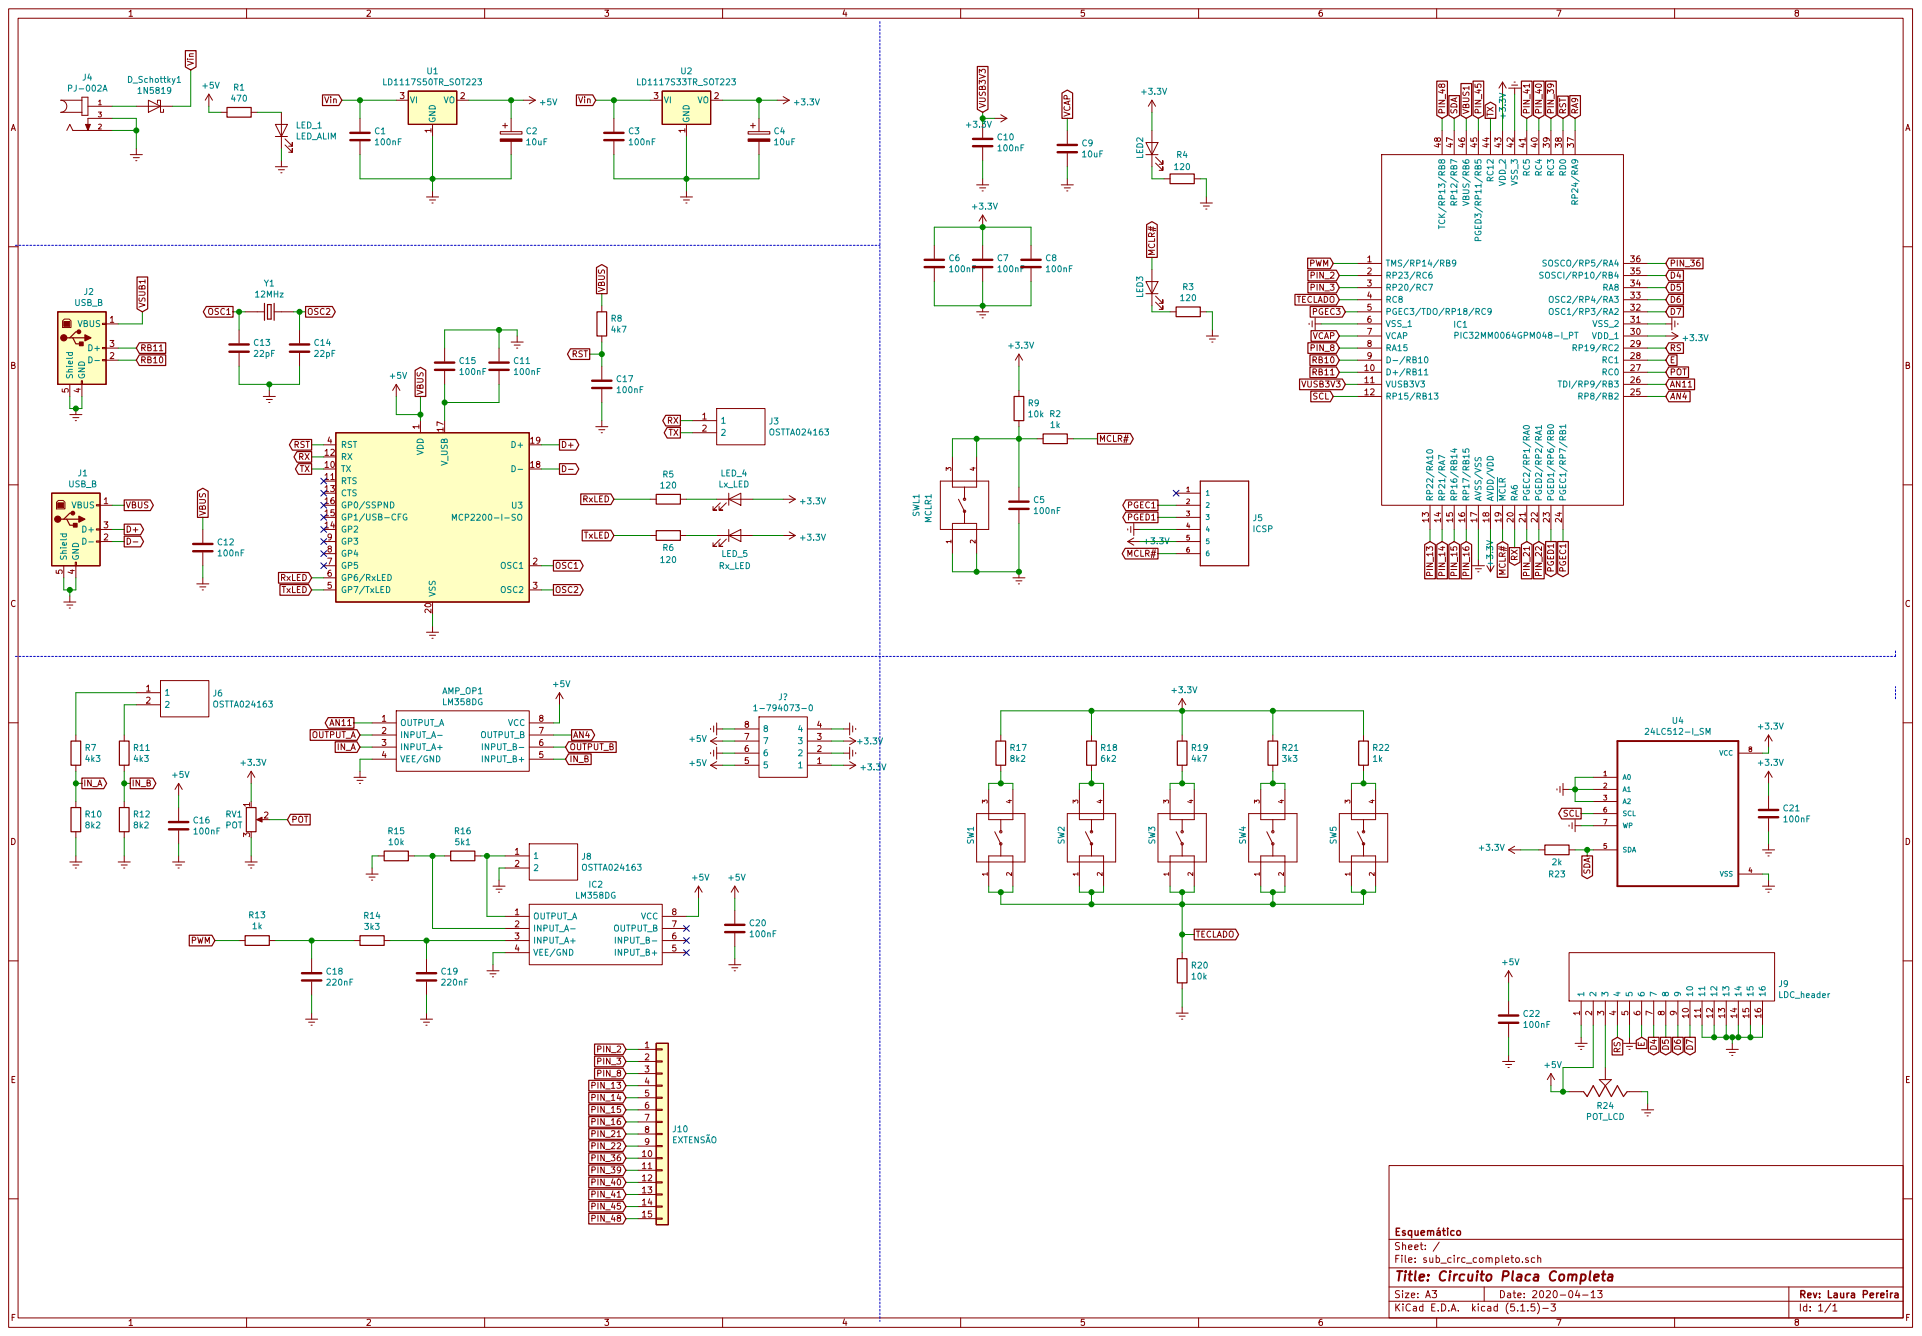
[picture p63: page 1]

1 TX 10 RTS 11 RX 12 CTS 13 GP2 14 GP1/USB-CFG 15 GP0/SSPND 16 V_USB 17 D- 18 D+ 19 OSC1 2 VSS 20 OSC2 3 RST 4 GP7/TxLED 5 GP6/RxLED 6 GP5 7 GP4 8 GP3 9 U3 MCP2200-I-SO LED3
12MHz C13

File: sub_circ_completo.sch Sheet: / Esquemático

Id: 1/1 Title: Circuito Placa Completa
