laurapellizari/PBLE01---Hardware/(list of files, drawings)

Other design files:
documentacao/componentes/filtro_butterworth.pdsprj
sub_circ_completos/sub_circ_completo.dsn
sub_circ_comunicacao/sub_circ_de_comunicacao.dsn
sub_circ_micro/sub_circ_micro.dsn
sub_circ_perifericos/sub_circ_perifericos.dsn
