laurapellizari/PBLE01---Hardware/sub_circ_interface/sub_circ_interface.kicad_pcb

## KiCad design sub_circ_interface/sub_circ_interface.kicad_pcb (2022-01-19)

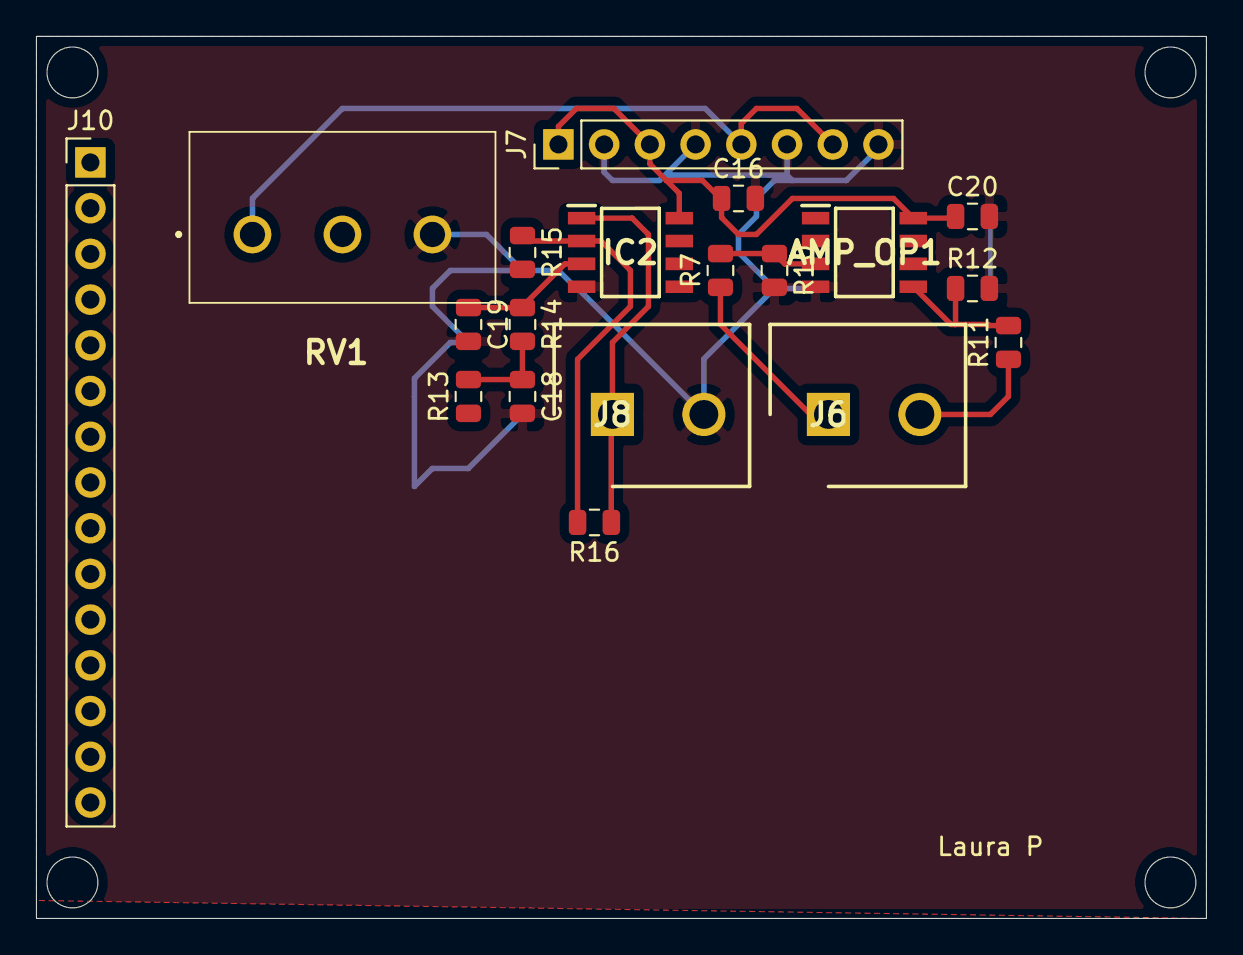
[picture p64: board sub_circ_interface.kicad_pcb from above]

Board: 2 copper layers, 65.0 x 49.0 mm, 19 parts (0 on the bottom side), 11 nets.

Parts:
AMP_OP1: LM358DG; SOIC127P600X175-8N
C16, C20: 100nF; C_0805_2012Metric
C18, C19: 220nF; C_0805_2012Metric
IC2: LM358DG; SOIC127P600X175-8N
J6, J8: OSTTA024163; SHDR2W100P0X508_1X2_1086X900X1300P
J7: ALIM; PinHeader_1x08_P2.54mm_Vertical
J10: EXTENSÃO; PinHeader_1x15_P2.54mm_Vertical
R7, R11: 4k3; R_0805_2012Metric
R10, R12: 8k2; R_0805_2012Metric
R13: 1k; R_0805_2012Metric
R14: 3k3; R_0805_2012Metric
R15: 10k; R_0805_2012Metric
R16: 5k1; R_0805_2012Metric
RV1: POT; P160KN0QD15B10K

Connections:
+3V3: J7.5, J7.7, RV1.1
+5V: AMP_OP1.8, C16.1, C20.1, IC2.8, J7.1, J7.3
Earth: AMP_OP1.4, C16.2, C18.2, C19.2, C20.2, IC2.4, J7.2, J7.4, J7.6, J7.8, J8.2, R10.2, R12.2, R15.2, RV1.3
IN_A: AMP_OP1.3, R7.2, R10.1
IN_B: AMP_OP1.5, R11.2, R12.1
unnamed: C18.1, R13.2, R14.2
unnamed: C19.1, IC2.3, R14.1
unnamed: IC2.1, J8.1, R16.1
unnamed: IC2.2, R15.1, R16.2
unnamed: J6.1, R7.1
unnamed: J6.2, R11.1
