laurapellizari/PBLE01---Hardware/sub_circ_micro/sub_circ_micro.kicad_pcb

## KiCad design sub_circ_micro/sub_circ_micro.kicad_pcb (2022-01-19)

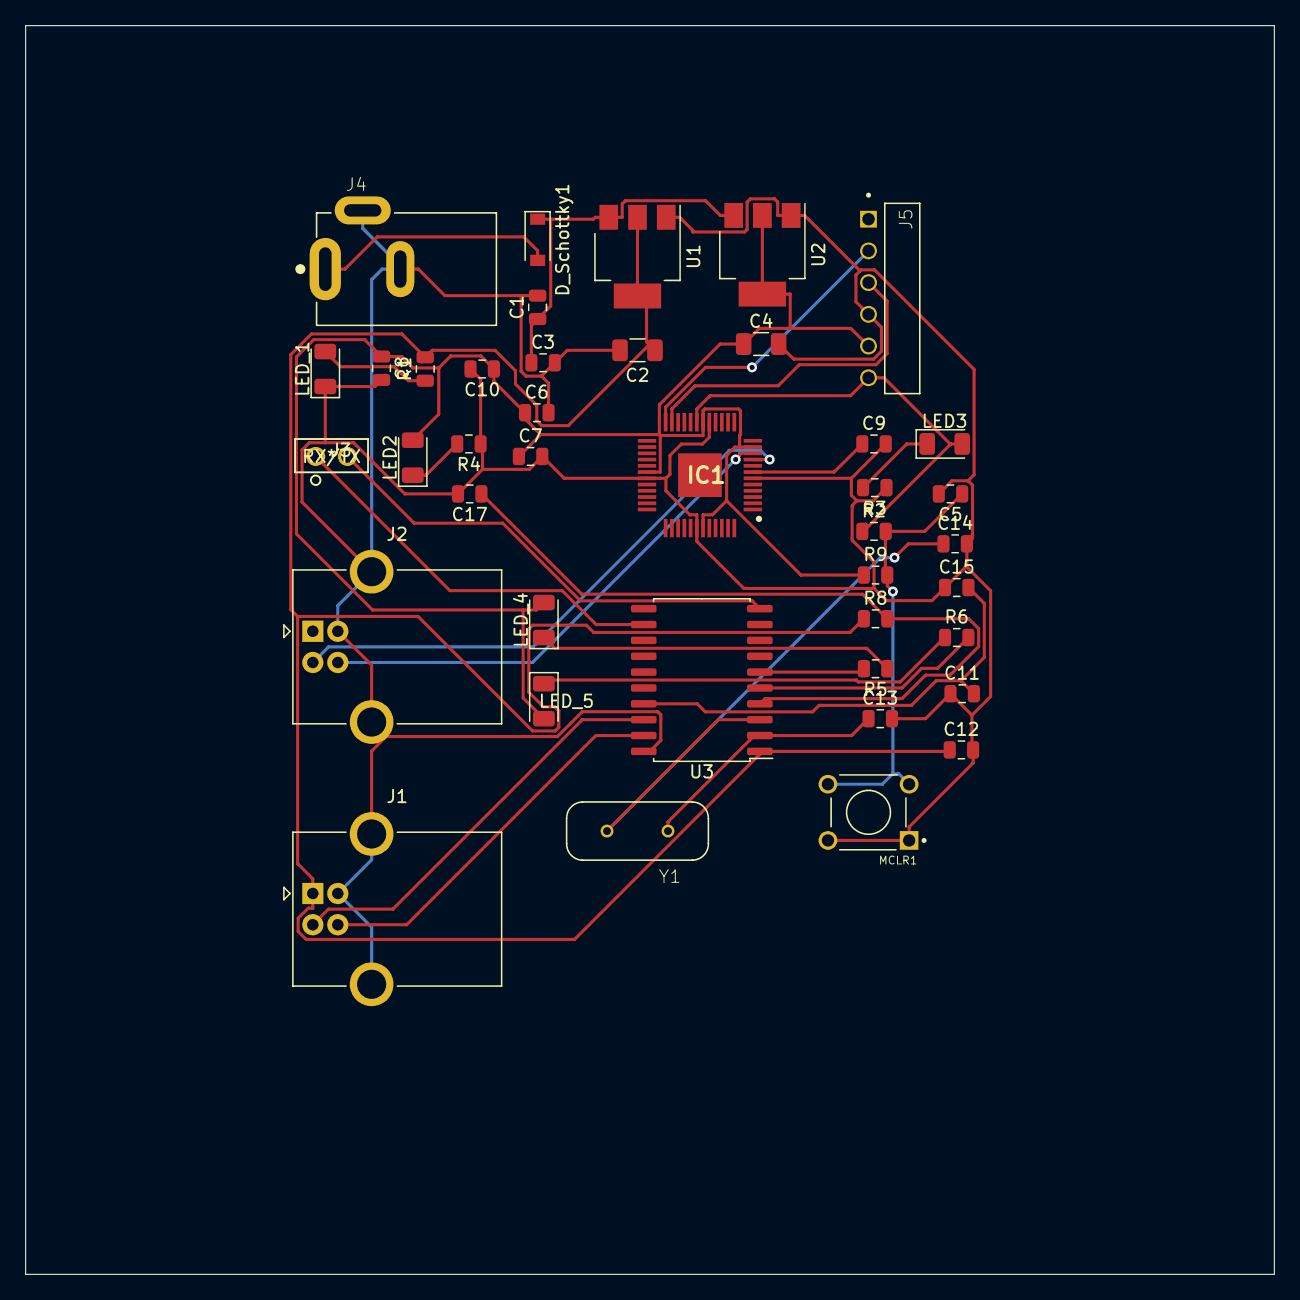
[picture p65: board sub_circ_micro.kicad_pcb from above]

Board: 2 copper layers, 100.0 x 100.0 mm, 41 parts (0 on the bottom side), 27 nets.

Parts:
C1, C3, C5, C6, C7, C8, C10, C11, C12, C15, C17: 100nF; C_0805_2012Metric
C2, C4: 10uF; C_1206_3216Metric
C9: 10uF; C_0805_2012Metric
C13, C14: 22pF; C_0805_2012Metric
D_Schottky1: 1N5819; D_SOD-123
IC1: PIC32MM0064GPM048-I_PT; QFP50P900X900X120-49N
J1, J2: USB_B; USB_B_OST_USB-B1HSxx_Horizontal
J3: RX/TX; SSQ-102-03-T-S
J4: PJ-002A; CUI_PJ-002A
J5: ICSP; TE_826951-6
LED2: LED]; LED_1206_3216Metric
LED3: LED; LED_1206_3216Metric
LED_1: LED_ALIM; LED_1206_3216Metric
LED_4: Lx_LED; LED_1206_3216Metric
LED_5: Rx_LED; LED_1206_3216Metric
MCLR1: SWL1; SW_1825910-6-4
R1: 470; R_0805_2012Metric
R2: 1k; R_0805_2012Metric
R3, R4, R5, R6: 120; R_0805_2012Metric
R8: 4k7; R_0805_2012Metric
R9: 10k; R_0805_2012Metric
U1: LD1117S50TR_SOT223; SOT-223-3_TabPin2
U2: LD1117S33TR_SOT223; SOT-223-3_TabPin2
U3: MCP2200-I-SO; SOIC-20W_7.5x12.8mm_P1.27mm
Y1: 12MHz; XTAL_ECS-120-20-4X

Connections:
D+: J1.3, U3.19
D-: J1.2, U3.18
Earth: C1.2, C2.2, C3.2, C4.2, C5.2, C6.2, C7.2, C8.2, C9.2, C10.2, C11.1, C12.2, C13.2, C14.2, C15.1, C17.2, IC1.6, IC1.17, IC1.31, IC1.42, J1.4, J1.5, J2.4, J2.5, J4.2, J4.3, J5.4, LED_1.1, MCLR1.1, MCLR1.2, R3.1, R4.1, U1.1, U2.1, U3.20
MCLR#: IC1.19, J5.6, LED3.2, R2.1
unnamed: C5.1, MCLR1.3, MCLR1.4, R2.2, R9.2
unnamed: C11.2, C15.2, U3.17
unnamed: D_Schottky1.2, J4.1
unnamed: LED2.1, R4.2
unnamed: LED3.1, R3.2
unnamed: LED_1.2, R1.1
unnamed: LED_4.1, R5.1
unnamed: LED_5.1, R6.1
OSC1: C13.1, U3.2, Y1.1
OSC2: C14.1, U3.3, Y1.2
PGEC1: IC1.24, J5.2
PGED1: IC1.23, J5.3
RB10: IC1.9, J2.2
RB11: IC1.10, J2.3
RST: C17.1, R8.2, U3.4
RX: J3.1, U3.12
RxLED: R5.2, U3.6
TX: J3.2, U3.10
TxLED: R6.2, U3.5
VBUS: C2.1, C12.1, J1.1, R1.2, R8.1, U1.2, U3.1
VCAP: C9.1, IC1.7
VUSB3V3: C4.1, C6.1, C7.1, C8.1, C10.1, IC1.11, IC1.18, IC1.30, IC1.43, J5.5, LED2.2, LED_4.2, LED_5.2, R9.1, U2.2
Vin: C1.1, C3.1, D_Schottky1.1, U1.3, U2.3
