laurapellizari/PBLE01---Hardware/sub_circ_comunicacao/sub_circ_de_comunicacao.kicad_pcb

## KiCad design sub_circ_comunicacao/sub_circ_de_comunicacao.kicad_pcb (2022-01-19)

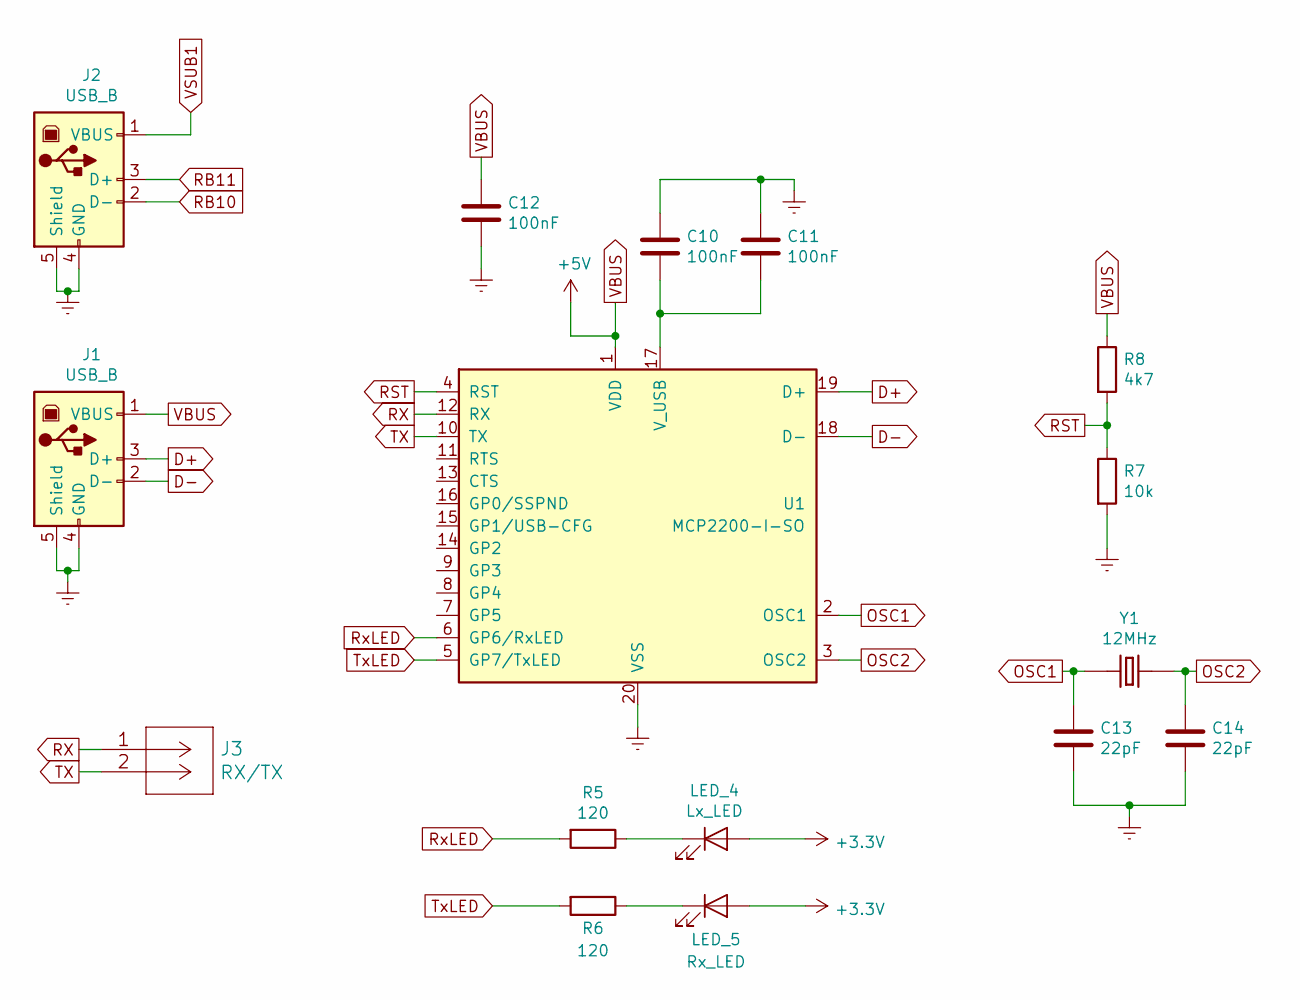
[picture p66: schematic sub_circ_de_comunicacao.sch]

Parts:
C10, C11, C12: 100nF; C_0805_2012Metric
C13, C14: 22pF; C_0805_2012Metric
J1, J2: USB_B; USB_B_OST_USB-B1HSxx_Horizontal
J3: RX/TX; SSQ-102-03-T-S
LED_4: Lx_LED; LED_1206_3216Metric
LED_5: Rx_LED; LED_1206_3216Metric
R5, R6: 120; R_0805_2012Metric
R7: 10k; R_0805_2012Metric
R8: 4k7; R_0805_2012Metric
U1: MCP2200-I-SO; SOIC-20W_7.5x12.8mm_P1.27mm
Y1: 12MHz; XTAL_ECS-120-20-4X

Connections:
+3V3: LED_4.2 (A), LED_5.2 (A)
D+: J1.3 (D+), U1.19 (D+)
D-: J1.2 (D-), U1.18 (D-)
Earth: C10.1, C11.1, C12.2, C13.2, C14.2, J1.4 (GND), J1.5 (Shield), J2.4 (GND), J2.5 (Shield), R7.2, U1.20 (VSS)
unnamed: C10.2, C11.2, U1.17 (V_USB)
unnamed: LED_4.1 (K), R5.1
unnamed: LED_5.1 (K), R6.1
OSC1: C13.1, U1.2 (OSC1), Y1.1
OSC2: C14.1, U1.3 (OSC2), Y1.2
RB10: J2.2 (D-)
RB11: J2.3 (D+)
RST: R7.1, R8.2, U1.4 (RST)
RX: J3.1, U1.12 (RX)
RxLED: R5.2, U1.6 (GP6/RxLED)
TX: J3.2, U1.10 (TX)
TxLED: R6.2, U1.5 (GP7/TxLED)
VBUS: C12.1, J1.1 (VBUS), R8.1, U1.1 (VDD)
VSUB1: J2.1 (VBUS)

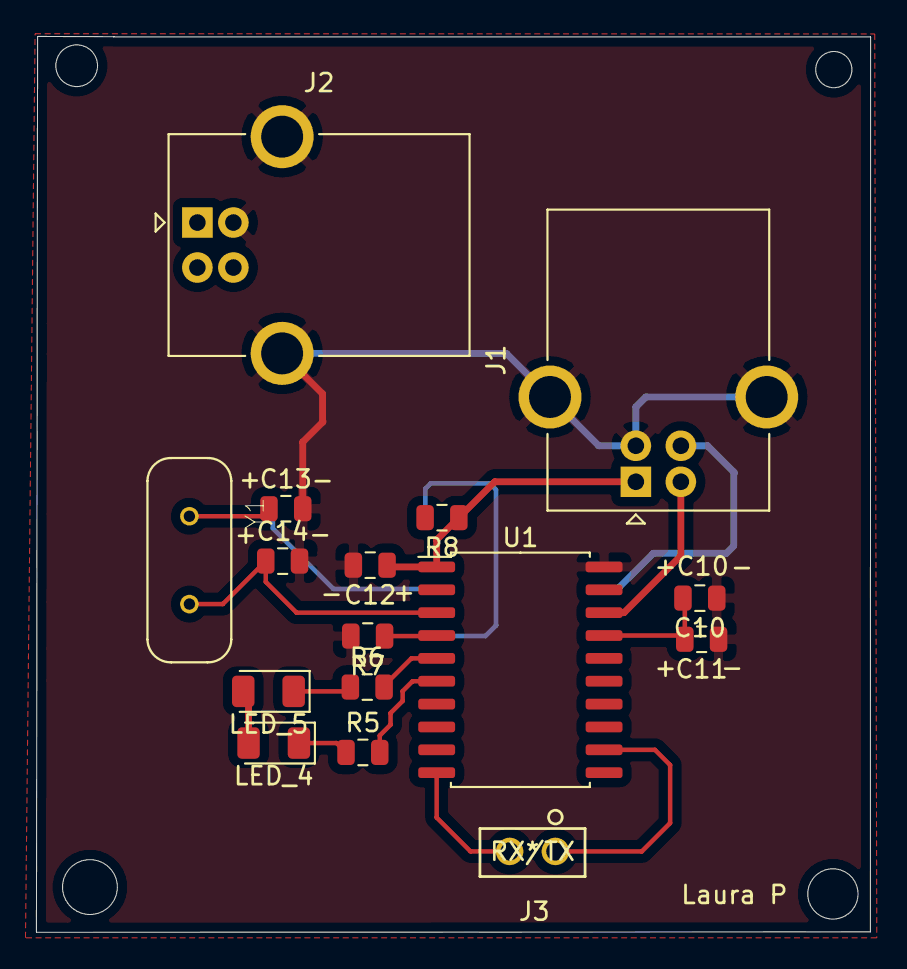
[picture p67: board sub_circ_de_comunicacao.kicad_pcb from above]

Board: 2 copper layers, 46.3 x 49.8 mm, 16 parts (0 on the bottom side), 15 nets.
