laurapellizari/PBLE01---Hardware/SW3/main.c

#include "config.h"
#include "pic18f4520.h"
#include "pwm.h"
#include "timer.h"
#include "adc.h"
#include "lcd.h"
#include "ssd.h"
#include "keypad.h"
#include "event.h"
#include "var.h"
#include "stateMachine.h"
#include "output.h"

void main(void) {


    //init das bibliotecas
    lcdInit();
    timerInit();
    varInit();
    eventInit();
    //outputInit();
    pwmInit();


    
    for (;;) {
        timerReset(getTime());
        smLoop();

        


        //máquina de estados*/

        


        timerWait();

        

    }
}
