laurapellizari/PBLE01---Hardware/SW3/stateMachine.h

/* 
 * File:   stateMachine.h
 * Author: Avell
 *
 * Created on 18 de Junho de 2017, 22:17
 */

#ifndef STATEMACHINE_H
#define	STATEMACHINE_H


//estados da maquina de Estados

enum {
    STATE_IDIOMA,
    STATE_ALARME,
    STATE_ALARME1,
    STATE_TEMPO,
    STATE_HORA,
    STATE_FIM
};


void smInit(void);
void smLoop(void);


#endif	/* STATEMACHINE_H */
