laurapellizari/PBLE01---Hardware/(notices)

Notices in the files:
SW3/lcd.c:
Copyright (C) Rodrigo Almeida 2010
Licença: GNU GPL 2
This program is free software; you can redistribute it and/or modify
it under the terms of the GNU General Public License as published by
the Free Software Foundation; version 2 of the License.
SW3/pic18f4520.h:
Copyright (C) Rodrigo Almeida 2014
parts and their libraries:
Copyright 2016 Accelerated Designs. All rights reserved.
